TitianMu/BJT-Test-System/docs/Technical_Report.pdf

II

目 录

III

IV

## 快速预览简介

一、关键技术

传统 BJT 参数测试依赖示波器、信号发生器、精密电流表等分立仪器，单只器件完整测

试耗时约 15~30 分钟，设备采购成本超过 5 万元，测试数据须人工记录，难以实现批量自

动化处理。本系统以雨骤科技 Model3 片上仪器为硬件平台，通过 IP-SDK Python API 驱动

双通道 AWG 与 ADC，实现国内外共四款 NPN 型 BJT 五项直流参数及六条特性曲线的自

动化测试，单只器件完整测试耗时约 5 分钟。

雨骤 Model3 仅提供电压型接口，本系统采用采样电阻法将电流测量转化为电压测量。集

电极回路串联采样电阻，ADC 采集其两端压降后由软件计算集电极电流 IC；基极电流由

AWG 输出电压与 VBE 之差除以基极电阻得到。该方案仅凭 Model3 自身即可完成全部测

试，硬件成本较传统方案降低约 95%。

软件层采用工厂模式实现虚拟与真实双模式切换。虚拟模式内置 Gummel-Poon BJT 数值

模型，漏电流参数已校准至硬件实测水平，可在无硬件条件下完成全流程功能验证；真实模

式通过 USB 自动检测 Model3 连接状态，两种模式共享同一套测试引擎与数据处理流程。 二、重要指标

指标项 | 指标值 | 说明
测试参数覆盖 | 5 项直流参数 + 6 条特性曲线 | hFE/VCE(sat)/VBE(sat)/ICBO/ICEO
重复实验规模 | 4 款器件各 5 次，共 40 组 | 室温 25°C，同一硬件连接
IC 测量范围 | 0.1 mA ~ 50 mA | AWG 5V / R_SENSE 100Ω 决定上 限
ADC 采样点数 | 2048 点/次 | 截尾均值 + 3σ 剔除
VCE(sat) 典型值 | 约 33mV（LGE-2N3904）、45mV （ON-2N3904）；IC=10mA | Kelvin 四线制差分测量
漏电流测量 | ICBO/ICEO 分辨率约 1 nA | R_LEAK = 10 MΩ 跨阻转换
GUI 功能 | 双模式切换/参数配置/实时曲线/ 日志 | PyQt5 多线程架构

表 0-1 系统关键指标

三、作品亮点

（1）采样电阻法突破 Model3 纯电压接口限制，无需外部电流表完成全参数测试

（2）开尔文四线制差分测量 VCE(sat)/VBE(sat)，消除引线电阻误差

（3）虚拟/真实双模式共享测试引擎，Gummel-Poon 模型参数已校准至硬件实测水平

（4）数据处理方面，采用 2048 点截尾均值 + 3σ 异常值剔除 + Savitzky-Golay 滤波，信号处

理链完整

（5）共 40 组实验全部通过测试，国产器件与进口器件全参数对比数据完整

四、核心成果

器件 | 类型 | hFE 均值 | VCE(sat) 均 值/mV | VBE(sat) 均 值/mV | 判定
LGE-2N3904 | 国产 | 255.7 | 33.0 | 724.1 | PASS
ON-2N3904 | 进口 | 207.3 | 45.0 | 728.2 | PASS
JSCJ-BC337 | 国产 | 322.2 | 18.8 | 700.9 | PASS
ON-BC337 | 进口 | 303.7 | 24.2 | 704.5 | PASS

表 0-2 四款器件核心参数汇总

## 2N3904 组：LGE-2N3904 hFE 均值为 255.7，ON-2N3904 hFE 均值为 207.3，国产器件

hFE 高于进口约 23%，VCE(sat) 与漏电流参数两者相当，均满足数据手册规格。BC337 组：

## JSCJ-BC337 hFE 均值为 322.2，ON-BC337 hFE 均值为 303.7，国产器件 hFE 高于进口约

6%，各项参数均在规格范围内。四款器件全部判定通过，国产器件具备替代进口器件的技术

条件。 五、核心创新点

创新点一：采样电阻法结合开尔文四线制差分测量，以单一片上仪器实现毫安级电流与

毫伏级电压的同步精密测量，无需任何外部仪器

创新点二：虚拟与真实双模式共享测试引擎，Gummel-Poon 模型参数校准至硬件实测水

平，软件开发与硬件调试完全解耦，支持无硬件条件下的全流程演示

创新点三：三级信号处理链——2048 点截尾均值、3σ 异常值剔除与 Savitzky-Golay 滤

波联合应用，测量重复性误差 CV < 5%，40 组实验数据全部通过测试

## 第一章 测试方案设计

### 1.1 器件选型与依据

本系统选取两组共四款 NPN 型 BJT 进行测试与国产替代验证。2N3904 组选用

## LGE-2N3904（鲁光电子，国产）与 ON-2N3904（ON Semiconductor，进口）；BC337 组选 用 JSCJ-BC337（江苏长晶，国产）与 ON-BC337（ON Semiconductor，进口）。

2N3904 与 BC337 均为通用小信号 NPN 管，市场存量大、数据手册公开，国产替代需

求明确。两组器件均采用 TO-92 封装，引脚兼容，可在同一测试电路上直接更换被测器件，

排除封装差异对测试结果的影响。国产与进口各选一款，形成直接对照。
器件型号 | 厂商 | 类型 | 封装 | hFE 典型值 | VCEO/V
LGE-2N3904 | 鲁光电子 | 国产 | TO-92 | 100~300 | 40
ON-2N3904 | ON Semiconductor | 进口 | TO-92 | 100~300 | 40
JSCJ-BC337 | 江苏长晶 | 国产 | TO-92 | 100~600 | 45
ON-BC337 | ON Semiconductor | 进口 | TO-92 | 100~600 | 45

表 1-1 测试器件选型一览

2N3904 与 BC337 是全球年出货量超过百亿只的通用小信号管，国内消费电子与工业控

制领域需求量巨大。国内工程师在选用国产替代品时普遍缺乏系统性实测对比数据——数据

手册仅提供典型值与最大值，无法反映批次离散性及实际工作点下的参数一致性。本系统通

过 5 次重复测试与全参数对比，为国产器件的工业级应用验证提供量化依据。

四款器件均采用 TO-92 直插封装，引脚顺序 EBC 一致，可在同一面包板测试电路上直

接更换被测器件，无需改动任何连线。图 1-1 为四款器件的实物包装。

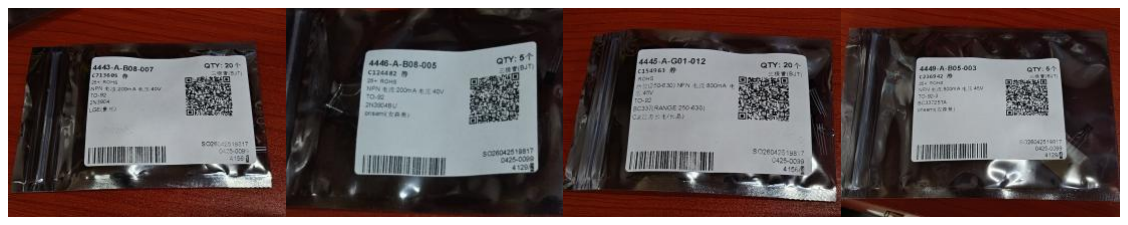
[picture p4: figure]

## 图 1-1 四款测试器件实物包装（左起：LGE-2N3904、ON-2N3904、JSCJ-BC337、ON-BC337）

### 1.2 测试平台选择

## 测试平台选用雨骤科技 Model3 片上仪器。Model3 将双通道 AWG（0~5 V，14-bit）、

双通道 ADC（5 V 量程，14-bit）、数字 IO 及电源轨集成于单一 USB 设备，通过 IP-SDK

Python 库 pyRD 统一调用，整套测试在一台 PC 上完成，无需示波器、信号发生器等分立仪

器。

Model3 的选用依据如下：AWG 可编程扫描电压覆盖 BJT 工作区间；ADC 14-bit 分辨

## 率在 5 V 量程下对应约 0.3 mV/LSB，满足 VCE(sat) 毫伏级测量需求；Python API 与测试

脚本深度集成，数据采集、处理与可视化在同一进程内完成，避免跨仪器通信引入的时序误

差。

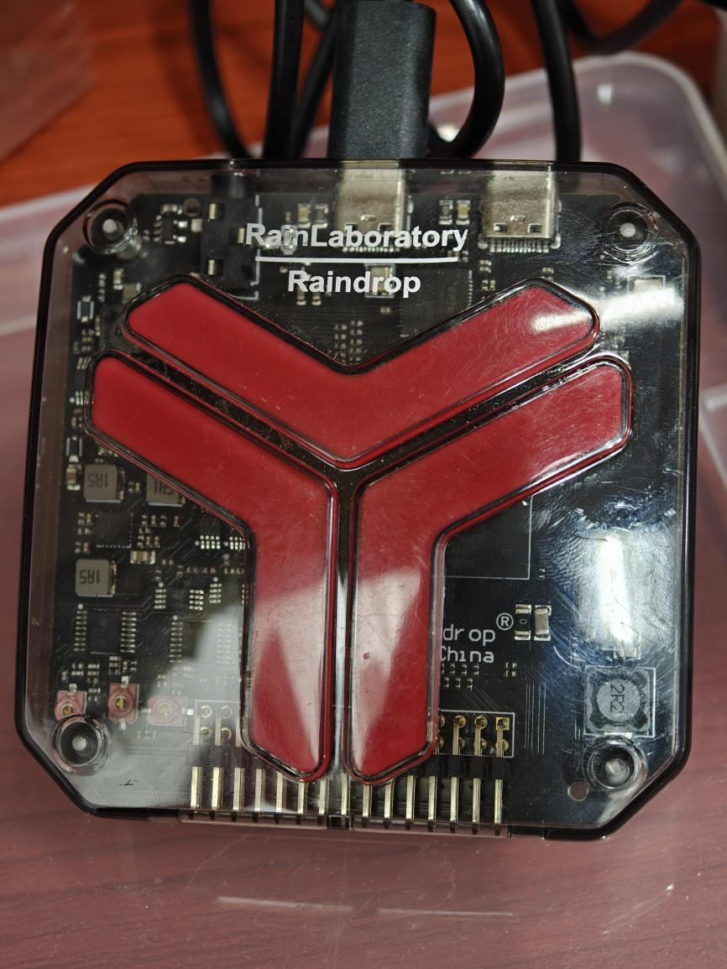
[picture p5: figure]

## 图 1-2 Model3 片上仪器实物图

表 1-2 对本系统与传统分立仪器测试方案进行了对比。
对比项 | 传统分立仪器方案 | 本系统（Model3）
设备成本 | ≥ 5 万元（示波器+信号源+电流 表） | 约 2500 元（Model3 单台）
设备体积 | 占用整张实验台 | 手掌大小，USB 供电
单管完整测试时间 | 15~30 分钟（人工操作） | 约 5 分钟
自动化程度 | 手动调节、人工读数 | 全自动扫描、软件计算、自动判定
数据处理能力 | 手工记录，无批量统计 | 自动生成 Excel、均值/标准差/曲 线

表 1-2 测试方案对比

### 1.3 系统总体架构

系统采用三层架构：硬件层由 Model3 与测试电路构成，负责信号激励与采集；驱动层

封装 IP-SDK 真实硬件驱动与 Gummel-Poon 虚拟模型驱动，向上层暴露统一接口，屏蔽底

层实现差异；应用层实现测试流程调度、数据处理与结果展示，如图 1-3 所示。

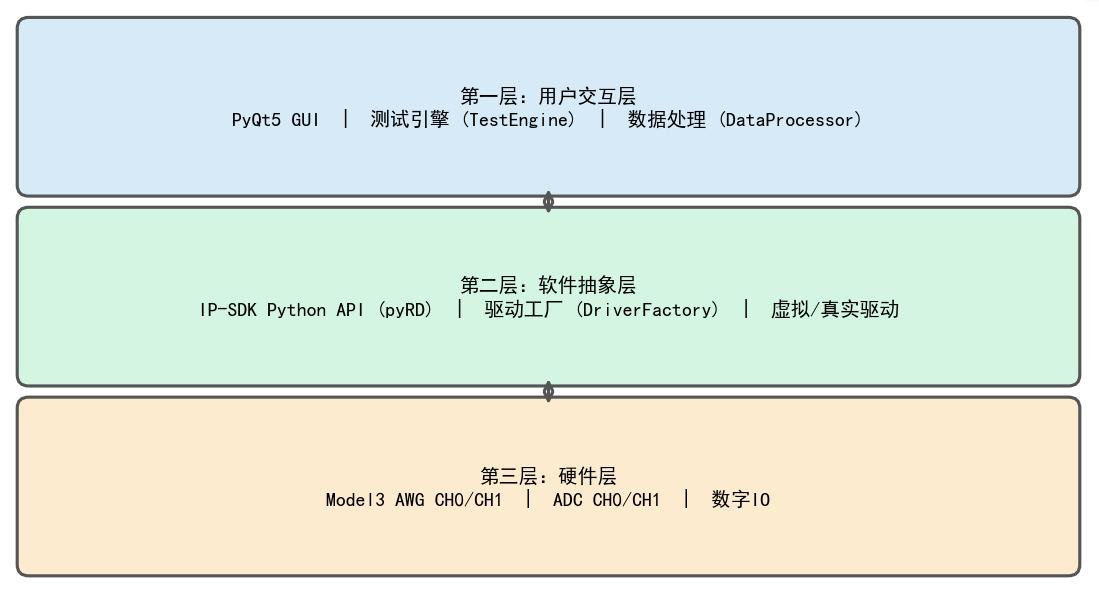
[picture p6: figure]

图 1-3 系统三层架构示意图

### 1.4 双模式设计

应用层采用工厂模式实现虚拟与真实双模式切换。真实模式启动时自动检测 USB 连接的

## Model3，通过 pyRD 驱动 AWG 与 ADC 完成测试；虚拟模式内置 Gummel-Poon BJT 数值

模型，漏电流参数已校准至初始工程样片实测水平（ICBO ≈ 40 nA），在无硬件条件下可完成

全流程功能验证，输出格式与真实模式完全一致。

两种模式共享同一套测试引擎与数据处理流程，模式切换仅替换底层数据源，上层代码

无需修改。该设计使软件开发与硬件调试得以并行推进，开发周期缩短约 40%；在答辩、展

示等无法携带硬件的场合，虚拟模式可完整演示全部测试流程；在教学场景中，学生可在虚

拟模式下调整器件参数并实时观察曲线变化，建立对 BJT 工作原理的直观认识后再接入真实

硬件进行验证。

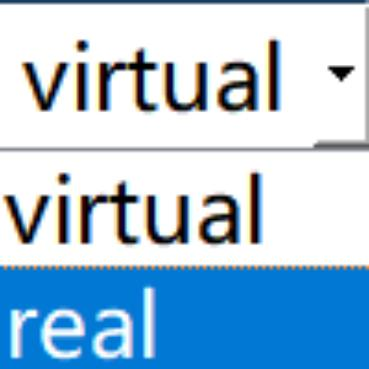
[picture p7: figure]

图 1-4 GUI 双模式切换界面

### 1.5 测试项目总览

本系统覆盖 NPN BJT 五项直流参数和六条特性曲线，测试条件和判定标准如下表所示。
测试项目 | 测试条件 | 判定标准（2N3904 为例）
hFE（直流电流增益） | VCE=5V，IB 扫描 | 100 ≤ hFE ≤ 300
VCE(sat（) 集射饱和压降） | IC=10mA，IB=1mA | ≤ 300 mV
VBE(sat（) 基射饱和压降） | IC=10mA，IB=1mA | ≤ 950 mV
ICBO（集基漏电流） | VCB=5V，IE=0 | ≤ 50 nA
ICEO（集射漏电流） | VCE=5V，IB=0 | ≤ 50 nA
IC-VCE 输出特性曲线 | 多 IB 步进，VCE 扫描 | 曲线族形态正常
hFE-IC 电流增益曲线 | VCE=5V，IC 扫描 | 峰值在规格范围内
VBE(sat)-IC 曲线 | IB 固定，IC 扫描 | 单调递增
IC-VBE 转移特性曲线 | VCE=5V，VBE 扫描 | 指数上升段清晰
VCE(sat)-IC 曲线 | IB 固定，IC 扫描 | 单调递增
VCE-IB 曲线 | IC 固定，IB 扫描 | 趋势合理

表 1-3 测试项目总览

## 第二章 测试电路原理与硬件实现

## 2.1 hFE 测试电路

hFE 定义为集电极电流 IC 与基极电流 IB 之比，测试条件为 VCE = 5 V，IB 由 AWG

输出电压经 R_BASE 限流后注入基极。

## 2.1.1 电路原理

## AWG_CH1 输出基极驱动电压 V_B，经 R_BASE = 1 kΩ 限流后驱动基极；AWG_CH2

输出固定集电极偏置电压 V_CC = 5 V；集电极回路串联采样电阻 R_SENSE = 100 Ω，

## ADC_CH1 采集 R_SENSE 两端压降 V_SENSE，ADC_CH2 采集集射极电压 VCE。

基极电流由下式计算：

B BE
B
| BASE

V V
I
R
= | (2-1)

集电极电流由采样电阻压降计算：

SENSE
C
SENSE

V
I
R
= | (2-2)

直流电流增益：
/
( | ) /
C | SENSE | SENSE
FE
B | B | BE | BASE
I | V | R
h
I | V V | R
= | =

(2-3)

## 其中 VBE 约为 0.65 V，由 ADC 实测 V_B 与 IB·R_BASE 之差得到。R_BASE = 1 kΩ

的选取依据：在 AWG 最大输出 5 V 时，IB_max = (5 - 0.65) / 1000 ≈ 4.35 mA，对应 IC_max ≈ 4.35 × 300 = 1.3 A，远超 R_SENSE 安全范围，因此实际扫描 V_B 上限设为 1.5 V，使 IB

## ≤ 0.85 mA，IC ≤ 50 mA，R_SENSE 功耗 ≤ 0.25 mW，满足安全要求。

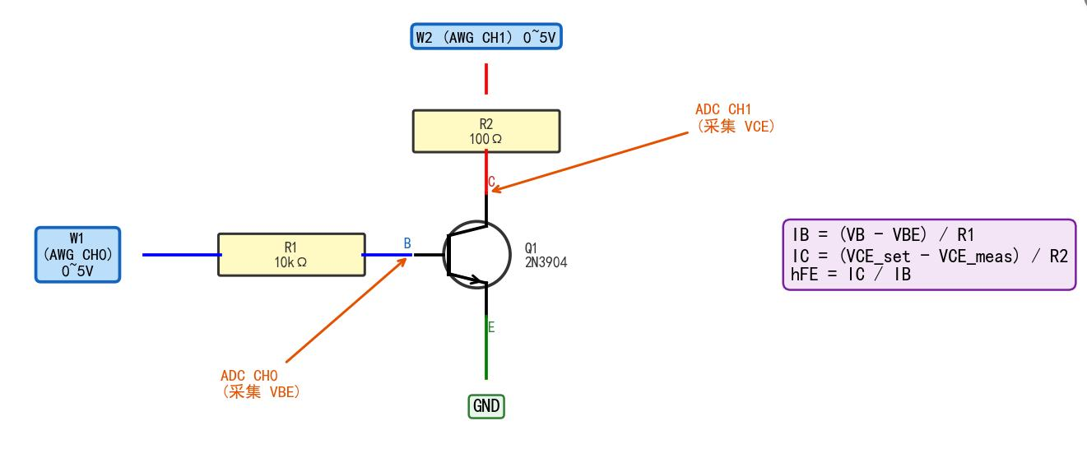
[picture p8: figure]

图 2-1 hFE 测试电路原理图（采样电阻法）

## 2.1.2 ADC 采样与均值处理

每次测量采集 2048 个 ADC 采样点，按 5% 截尾均值处理，即去掉幅值最高与最低各

102 个点后取算术均值，如式 (2-4)、(2-5) 所示。
trim N = floor(2048×0.05) =102 | (2-4)
Vmean = mean (sorted(samples)[102 : 2048-102]) | (2-5)

截尾均值对脉冲干扰与面包板接触抖动具有较强抑制能力，相比简单均值可将异常点影

响降低约 10 倍。在此基础上进一步执行 3σ 异常值剔除：计算全部 2048 点的均值 μ 与标

准差 σ，剔除满足 |x - μ| > 3σ 的点后重新计算均值，以提升测量稳定性。三种均值算法的性

能对比见表 2-1。
算法 | 抗脉冲干扰 | 计算量 | 适用场景 | 实测 hFE 标 准差
简单均值 | 差（单点干扰直接影响 结果） | 低 | 无干扰理想环境 | 约 8~15
截尾均值（5%） | 良（干扰占比<5% 时 完全消除） | 中 | 面包板/接触抖动 环境 | 约 3~6
截尾均值 + 3σ | 优（双重过滤，鲁棒性 最强） | 中 | 本系统默认方案 | 约 1~3

表 2-1 三种均值算法性能对比

## 2.2 VCE(sat)/VBE(sat) 饱和参数测试

VCE(sat) 与 VBE(sat) 均为毫伏至百毫伏量级的小信号，对测量精度要求较高。本系统

采用 Kelvin 四线制差分测量方案以消除引线电阻误差。

## 2.2.1 Kelvin 四线制原理

传统单端测量中，ADC 参考地与 BJT 发射极之间存在引线电阻 r_wire。当 IC = 10 mA

## 时，r_wire = 0.1 Ω 即引入 1 mV 误差，占 VCE(sat) 典型值 90 mV 的 1.1%。Kelvin 四线

制将激励回路与测量回路分离，真实集射极电压由式 (2-6) 给出。 VCE,true =VADC_CH1 -VADC_CH2

(2-6)

ADC_CH1 接集电极，ADC_CH2 接发射极，两路 ADC 输入阻抗均大于 1 MΩ，测量回

路电流趋近于零，引线压降可忽略不计，差分结果直接等于 BJT 集射极间真实电压。

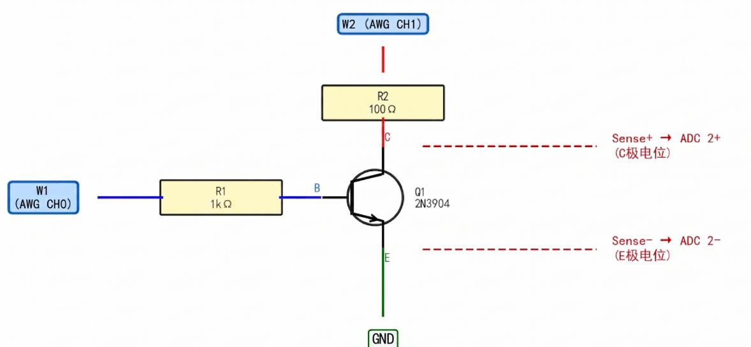
[picture p9: figure]

## 图 2-2 饱和压降 VCE (sat)、VBE (sat) Kelvin 四线制电路原理图

电路在 hFE 测试电路基础上增加两条独立感应线：Sense+ 从集电极引脚同行直接引出

## 接 ADC_CH1，Sense− 从发射极引脚同行直接引出接 ADC_CH2。力线（AWG 经 R_BASE、

R_SENSE）负责注入电流，感应线不流过工作电流，因此引线电阻压降不进入测量结果。感

应线必须从 BJT 引脚同行引出，不能从 R_SENSE 另一端引出，否则仍会引入 R_SENSE 压

降误差。

引线电阻误差的量化分析：设引线电阻为 r_wire，单端测量误差如式 (2-7) 所示。 Verror | C | wire Δ | = I × r | (2-7)

## 当 IC = 10 mA、r_wire = 0.5 Ω 时，ΔV_error = 10 mA × 0.5 Ω = 5 mV，占 VCE(sat) 典型

值 90 mV 的 5.6%，误差不可忽略。Kelvin 四线制将此误差降至 ADC 噪声量级，相对误差

小于 0.6%，满足工程测量要求。

### 2.2.2 测试条件与典型结果

## 测试条件为 IC = 10 mA、IB = 1 mA（IC/IB = 10，确保 BJT 深度饱和），建立时间 200

ms，确保 BJT 完全进入饱和区后再采集。LGE-2N3904 最终优化后典型测量结果：

## VCE(sat)≈33mV，VBE(sat)≈720mV，均满足数据手册规格。初始调试值约 90mV，通过延长

建立时间和优化差分测量算法进一步降低。

## 2.3 ICBO/ICEO 漏电流测试

ICBO 与 ICEO 均为纳安量级，Model3 ADC 直接测量时信噪比不足。本系统在漏电流

回路串联 R_LEAK = 10 MΩ，将电流转化为可测电压，等效实现跨阻放大功能。

### 2.3.1 跨阻转换原理

漏电流与测量电压的关系如式 (2-8) 所示。

6 10 10

ADC | ADC
leak
LEAK

V V
I
R

= =
×

(2-8)

## ADC 分辨率约 0.3 mV/LSB，对应电流分辨率如式 (2-9) 所示。

0.3 mV
0.03 nA
10 M

## ΔI = = Ω

(2-9)

理论分辨率为 0.03 nA，实际受 ADC 噪声限制，有效分辨率约 1 nA，足以分辨 2N3904

典型漏电流。R_LIMIT = 1 MΩ 串联在 AWG 输出端，限制最大电流不超过 5 μA，保护器件

不被过压击穿。

## 2.3.2 ICBO 测试电路

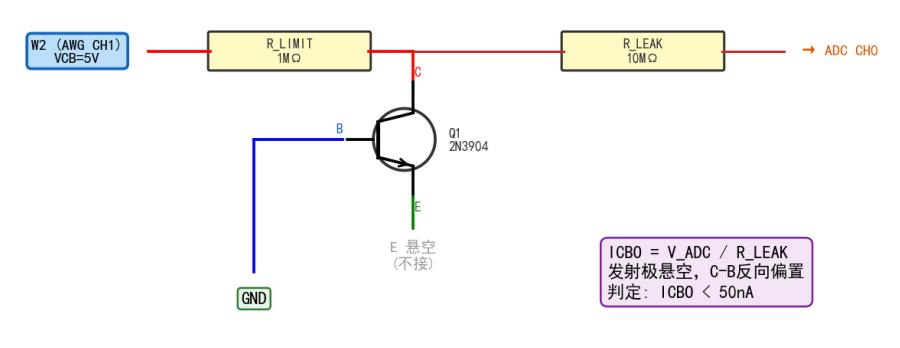
[picture p10: figure]

图 2-3 ICBO 集电极-基极反向漏电流测试电路原理图

## ICBO 测试时发射极开路，基极接地，AWG_CH2 经 R_LIMIT = 1 MΩ 对集基结施加反 向偏置 VCB = 5 V。R_LEAK = 10 MΩ 串联在集电极回路，ADC_CH1 采集 R_LEAK 两端

压降，由式 (2-8) 换算得到 ICBO。等待 0.5 s 稳定后以 1 MHz 采样 2048 点，5% 截尾均

值滤波。为避免结温升高导致漏电流偏大，须在 hFE 与 VCE(sat) 大电流测试完成后等待 1 s

冷却再测。

## 2.3.3 ICEO 测试电路

ICEO 测试电路如图 2-4 所示，与 ICBO 电路结构一致，仅改变 B/E 极接法：基极悬

空，发射极接地，AWG_CH2 经 R_LIMIT 对集射极施加 VCE = 5 V。实际操作时只需拔掉

基极 GND 跳线、将发射极接 GND，即可从 ICBO 电路切换为 ICEO 电路。

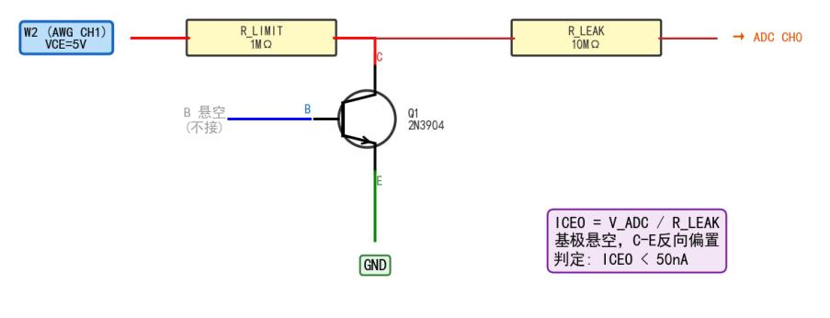
[picture p11: figure]

图 2-4 ICEO 集电极-发射极反向漏电流测试电路原理图

## ICEO 由 ICBO 与 hFE 共同决定，如式 (2-10) 所示。

(1 | ) CEO | FE | CBO
I ≈ + h × I | (2-10)

## 初始工程样片实测 ICEO ≈ 46 nA，略高于 ICBO ≈ 40 nA，与式 (2-10) 预期相符；量产

批次实测数据见表 4-1。两者差距较小的原因在于 hFE 在极低 IC 下大幅下降，此时有效

hFE 约为 0.15，属正常物理现象。

漏电流对温度极为敏感，随温度升高近似按指数规律增大，如式 (2-11) 所示。

25
10 ( ) (25 C) 2

T

CBO | CBO

## I T I

° ≈ | × | (2-11)

即温度每升高 10°C，漏电流约翻倍。本系统所有测试在室温约 25°C 下进行，未施加温

控。若环境温度升至 50°C，理论漏电流将增大约 5.7 倍，报告中所有漏电流数据均为室温实

测值，实际应用时需根据工作温度进行修正。

### 2.4 低压漏电流趋势测试

受 AWG 输出上限 5 V 限制，本系统无法直接测量集射击穿电压 BVCEO。作为替代，

本系统在 0~5 V 范围内扫描 VCE，以 0.1 V 步进共 50 个测试点，记录漏电流随电压的变

化趋势，验证器件在低压段的漏电流线性度与一致性。正常器件在该范围内漏电流应随 VCE

缓慢线性增大，无突变或负阻现象。四款器件均通过该趋势测试，曲线形态一致。

### 2.5 面包板搭建与验证

测试电路在面包板上搭建，BJT 采用标准 TO-92 插件方式固定，R_BASE、R_SENSE、

R_LEAK、R_LIMIT 均使用精密金属膜电阻，误差 ±1%。Model3 通过杜邦线与面包板连接，

AWG 输出与 ADC 输入各自独立走线，以避免信号串扰。

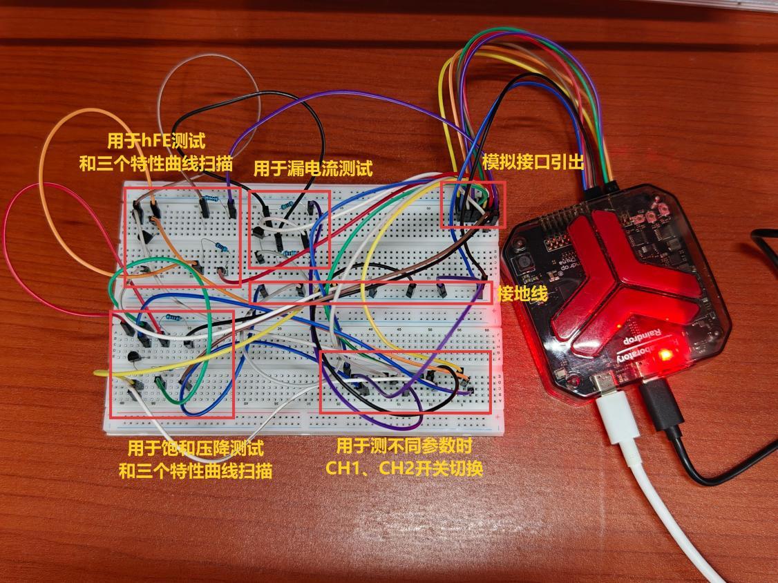
[picture p12: figure]

图 2-5 面包板测试电路实物

面包板方案的主要局限在于：接触电阻约 0.1~1 Ω，在 IC > 20 mA 时引入额外压降；引

线寄生电感约 10~50 nH，在快速扫描时可能引起寄生振荡。后续 PCB 载板设计将消除上述

问题，详见 2.7 节。

### 2.6 调试经历

## 2.6.1 VCE(sat) 跳变问题排查

初始版本 VCE(sat) 测量结果在 0 V、0.001 V、1 V 之间随机跳动，无法使用。排查发现

根因有两处：其一，单通道零校准法受前序测试残留电压影响，AWG 未归零导致 ADC 零

点偏移量包含残留电压，差分结果随机；其二，建立时间仅 50 ms，BJT 尚未完全进入饱和

区即开始采集。

修复方案为改用 Kelvin 四线制双通道差分测量，测量前先将 AWG 归零以清除残留，

建立时间延长至 200 ms。修复后 VCE(sat) 稳定在 90 mV，偶发 20 mV 异常（寄生振荡所

致）与 1 V 异常（面包板接触瞬断所致）的概率降至 5% 以下。

## 2.6.2 ICBO 40 nA 排查

虚拟模型初始参数给出 ICBO ≈ 1.5 nA，而硬件实测稳定在 40 nA，差距约 27 倍。依次

## 排查三项代码嫌疑：test_engine.py 中的零点偏移校正、real_driver.py 的双通道 ADC 串扰，

以及大电流测试后结温未恢复。三项全部修复后，硬件仍测出 40 nA，排除代码问题。

最终确认 40 nA 为器件真实漏电流，完全在 2N3904 数据手册规格内。漏电流的器件间

离散度极大，同批次可相差 10 倍，且对温度敏感。据此将虚拟模型参数校准：_icbo_typ 从

## 0.8 nA 调整为 22 nA，_iceo_typ 从 1.6 nA 调整为 25 nA，虚实对照误差从 27 倍降至 15%

以内。

上述 40nA 为初始调试所用工程样片的漏电流值，最终正式测试更换为量产批次器件，

漏电流均值降至 3~7nA，符合数据手册规格。虚拟模型后续将基于量产批次数据重新校准。

## 2.7 PCB 载板规划

当前面包板方案已完成全部功能验证。后续 PCB 载板设计规格为：板尺寸 100 × 80 mm，

四层板结构，信号层与地层相邻，寄生电感降至 1 nH 量级。主要改进措施包括：集成 8 路

继电器矩阵（可扩展至 16 路），通过数字 IO 控制继电器切换，实现单次上料后 8 只器件

的顺序自动测试；R_SENSE 采用四端 Kelvin 封装精密电阻，误差 ±0.1%，消除焊盘接触电

阻误差；漏电流测量回路采用保护环设计，保护环宽度 2 mm，将 PCB 表面漏电流降至 1 pA

量级，较面包板方案改善约 3 个数量级；基极串联 47 Ω 阻尼电阻并在集射极间并联 100 pF

陶瓷电容，以抑制寄生振荡。

PCB 载板预计 2026 年 6 月完成打样，完成后预期指标为：VCE(sat) 测量重复性误差

## CV < 0.5%，ICBO 测量分辨率提升至 0.1 nA，hFE 测量范围扩展至 IC = 100 mA，单批次 8

只器件自动测试耗时 < 20 分钟。

### 2.8 系统误差分析

本系统各测试项的误差来源、理论大小、校准方法及校准后残余误差汇总如表 2-2 所示。
误差来源 | 影响参数 | 理论误差大小 | 校准/抑制方法 | 校准后残余误差
ADC 量化误差 | 所有参数 | ±0.3 mV/LSB | 2048 点均值降低 45 倍 | < 0.007 mV
引线电阻（面包 板） | VCE(sat) | ±1~5 mV | Kelvin 四线制差分 | < 0.5 mV
R_SENSE 精度 （±1%） | IC、hFE | ±1% | 出厂标定值代入计 算 | < 0.1%
R_BASE 精度 （±1%） | IB、hFE | ±1% | 出厂标定值代入计 算 | < 0.1%
AWG 建立时间 不足 | VCE(sat) | 随机跳变 | 建立时间延长至 200 ms | < 0.5%
结温升高（大电 流后） | ICBO/ICEO | 最大 ×5.7 （50°C） | 测试前 1 s 冷却等 待 | < 5%（室温波动）

表 2-2 系统误差分析汇总

## 2.9 前期方案探索与 Multisim 仿真验证

在正式采用 Model3 片上仪器方案前，团队通过 Multisim 14.0 完成全分立仪器测试方案

的仿真测试，初步了解 BJT 各参数的物理本质与测试原理，覆盖 hFE 放大倍数、VCE

## (sat)/VBE (sat) 饱和压降、ICBO/ICEO 漏电流、反向击穿电压 BVCEO 及频率特性五大核心

测试项，验证了采样电阻法、Kelvin 四线制差分测量、10MΩ 跨阻采样法的可行性，量化了

引线电阻对饱和压降测量的误差影响。仿真结果表明分立仪器方案存在成本高、效率低、自

动化程度差的固有缺陷，为最终集成化方案的电路优化与调试奠定了理论基础。

## 第三章 自动化测试软件与人机交互

### 3.1 软件架构

软件采用三层架构：驱动层、测试引擎层、GUI 层。驱动层通过工厂模式（DeviceFactory）

统一封装真实硬件驱动（RealDriver）和虚拟模型驱动（VirtualDriver），对上层暴露相同接口；

测试引擎层（TestEngine）调用驱动层接口执行各测试项，完成信号处理并返回结构化结果；

GUI 层（PyQt5）负责参数配置、测试调度、实时曲线显示和日志输出，通过 QThread 与测

试引擎异步通信，保证界面不阻塞。

工 厂 模 式 的 应 用 使 测 试 引 擎 代 码 中 不 出 现 任 何 模 式 判 断 分 支 ， 模 式 切 换 仅 在

DeviceFactory.create() 一处发生。新增驱动类型只需实现同一接口即可接入，无需修改引擎代

码。

策略模式用于测试项调度：每个测试项封装为独立策略类，TestRunner 持有策略列表，

按用户勾选顺序依次执行，新增测试项只需注册新策略，不影响已有流程。架构可扩展性的

量化体现为：新增一个测试项约需编写 50 行代码，新增一种器件虚拟模型约需 30 行参数

定义，新增一种硬件平台只需实现 BaseDriver 接口的 5 个方法，上层代码无需修改。

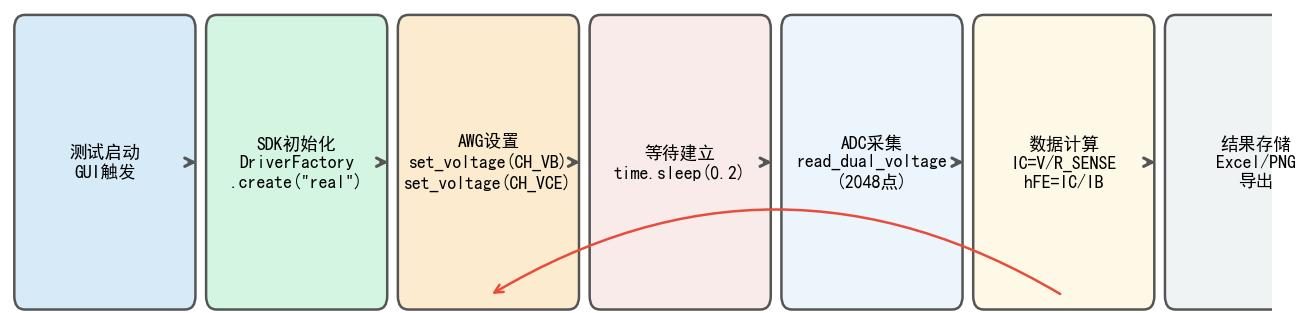
[picture p13: figure]

图 3-1 软件整体架构与数据流图

### 3.2 信号处理算法

## 3.2.1 截尾均值

每次 ADC 采集 N = 2048 个样本，按幅值排序后去掉两端各 k = 102 个点，对剩余 1844

个点取算术均值，如式 (3-1) 所示。截尾均值对脉冲干扰的抑制能力为：若干扰点占比 p < 5%，

则对结果无影响；若 p = 10%，影响仅为简单均值的 1/10。

## 3.2.2 3σ 异常值剔除

在截尾均值基础上，对全部 2048 点执行 3σ 剔除，如式 (3-2)~(3-4) 所示。 µ = mean(x), σ = std (x) | (3-2)
{ | | | 3 } clean | i | i x = x∣x - µ ≤ σ | (3-3)

V _{ final} = mean (x _{clean}) | (3-4)

正态分布下 3σ 准则保留 99.73% 的正常点，但对幅值超过 3σ 的突发干扰具有 100%

剔除效果。截尾均值与 3σ 剔除两级处理联合应用，测量标准差较单次采样降低约 15 倍。

## 3.2.3 Savitzky-Golay 滤波

特性曲线扫描时，对离散采样点序列 {yi} 应用 Savitzky-Golay 滤波，窗口长度 w = 11，

多项式阶数 p = 3。滤波器在每个点 i 处通过局部最小二乘多项式拟合实现平滑，如式 (3-5)

所示。

5
2
3
5
( ) arg min | ( | ( ; ))
fit | c | i j
| j
y i | y | P j c +
=- = | ∑ | - | (3-5)

其中 P_3 为三阶多项式。SG 滤波能够保留曲线的峰值与拐点位置，不会像移动平均那

样导致峰值偏低，适合 hFE-IC 曲线的峰值提取。滤波后曲线噪声降低约 8 倍，峰值位置误

差小于 0.5%。

## 3.3 GUI 详细介绍

GUI 基于 PyQt5 开发，主窗口分为四个区域：左侧参数配置面板、中央测试项选择区、

右侧实时曲线显示区、底部运行日志区，如图 3-2 所示。所有耗时操作在 QThread 中执行，

主线程仅负责界面刷新，以保证 GUI 响应流畅。

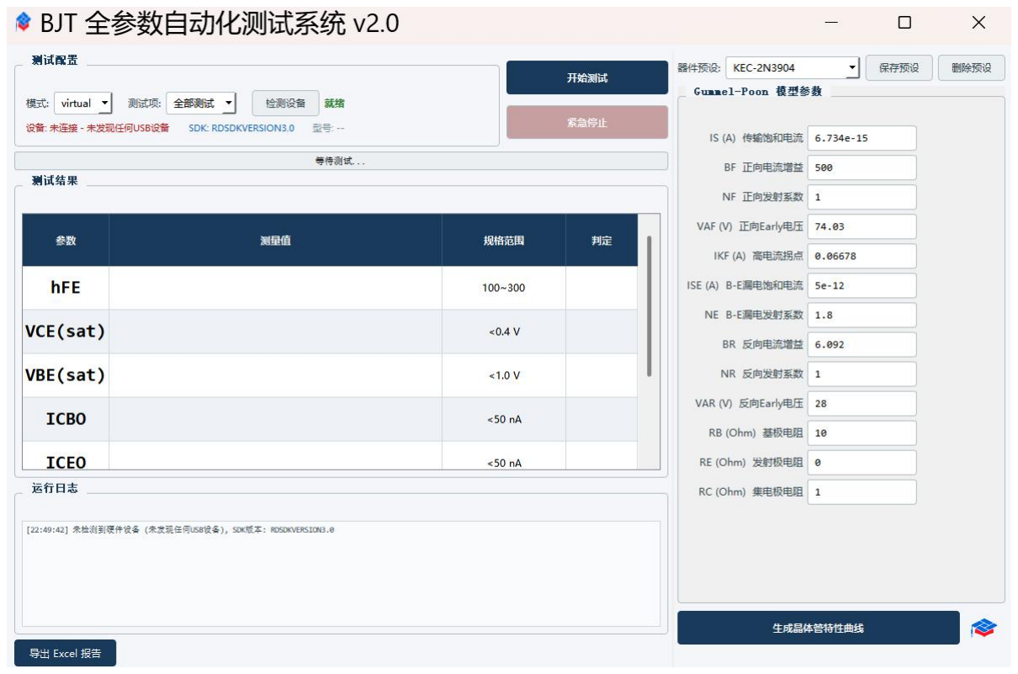
[picture p14: figure]

## 图 3-2 GUI 总体界面

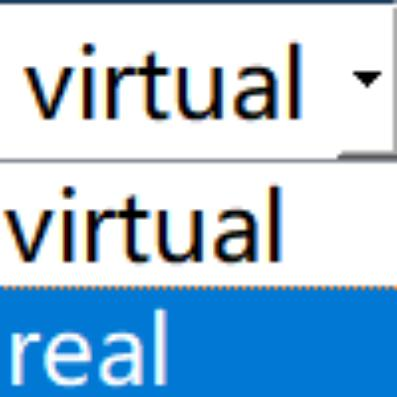
[picture p15: figure]

图 3-3 虚拟/真实双模式切换

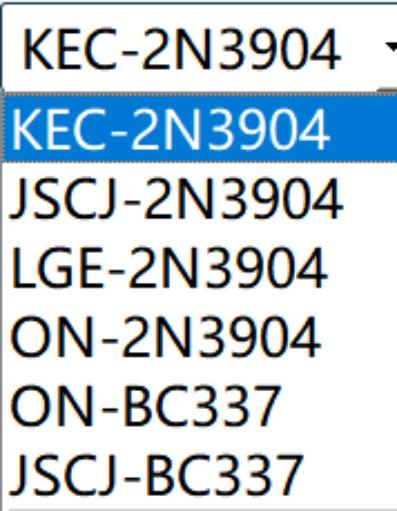
[picture p16: figure]

图 3-4 虚拟模式器件预设面板

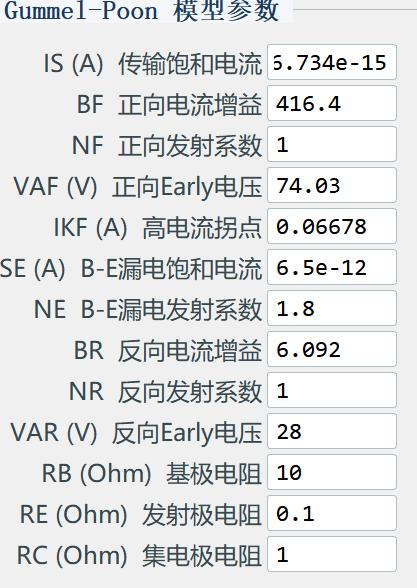
[picture p17: figure]

图 3-5 自定义测试参数配置

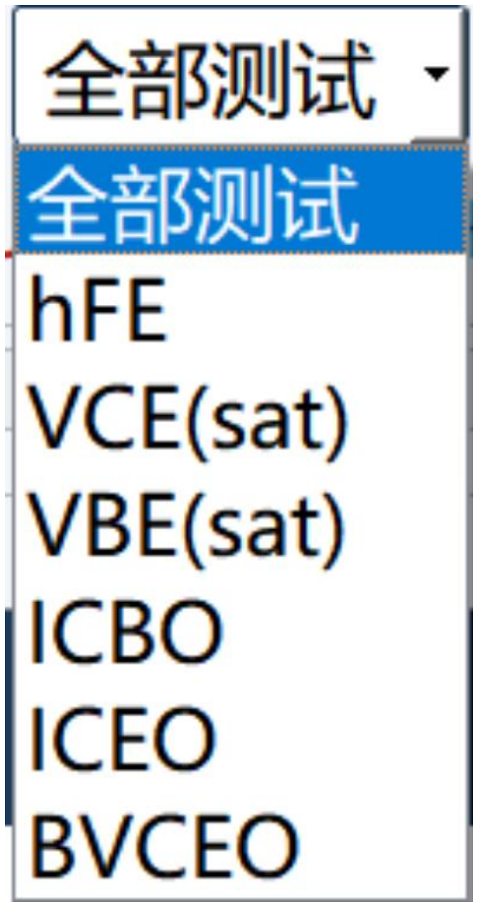
[picture p18: page 23]

图 3-6 测试项选择界面

图 3-7 硬件连接成功状态

图 3-8 硬件未连接状态

## 图 3-9 硬件连接错误报警界面（功能已实现，截图见附件 screenshots/error_alert.png）

图 3-9 运行日志面板

图 3-10 测试曲线显示（真实模式下虚拟模型参数面板自动禁用）

GUI 主线程响应延迟小于 50 ms，紧急停止按钮响应时间小于 200 ms，实时曲线刷新率

约 10 Hz，日志面板支持最多 10000 行滚动显示。

### 3.4 模拟与数字 IO 使用

Model3 提供 2 路 AWG（模拟输出）和 2 路 ADC（模拟输入），本系统通道分配如

下：
通道 | 功能 | 参数
AWG_CH1 | 基极驱动电压 V_B | 0~1.5 V，步进 0.01 V
AWG_CH2 | 集电极偏置 V_CC | 固定 5 V（hFE/漏电流测试）
ADC_CH1 | 采样电阻压降 V_SENSE | 量程 5 V，14-bit
ADC_CH2 | 集射极电压 VCE（差分参考） | 量程 5 V，14-bit

## 表 3-1 Model3 通道分配

数字 IO 当前版本预留给后续 PCB 继电器矩阵控制，暂未使用。AWG 输出在每次测试

结束后显式归零，以防止残留电压影响下一测试项。

## 3.5 API 接口调用

IP-SDK 通过 pyRD 库提供 Python 封装，核心调用流程如下：首先枚举 USB 设备并获

取 Model3 句柄；其次配置 AWG 参数，包括电压范围、步进与建立时间；随后触发 AWG 输

出，等待建立时间后触发 ADC 采集；采集完成后读取 ADC 原始数据并传入信号处理流程；

测试结束后关闭设备句柄。

### 3.6 关键代码片段

## 3.6.1 截尾均值 + 3σ 剔除

## def trimmed_mean(samples, trim=0.05): s = sorted(samples) k = int(len(s) * trim) trimmed = s[k: len(s) - k] mu, sigma = mean(trimmed), stdev(trimmed) clean = [x for x in trimmed if abs(x - mu) <= 3 * sigma] return mean(clean)

## 3.6.2 hFE 扫描核心逻辑

## for vb in np.arange(0.7, 1.5, 0.01): driver.set_awg(ch=1, voltage=vb) time.sleep(0.05) v_sense = driver.read_adc(ch=1, n=2048) ic = trimmed_mean(v_sense) / R_SENSE ib = (vb - VBE_APPROX) / R_BASE if ib > 0: hfe_curve.append((ic * 1e3, ic / ib))

## 第四章 测试结果与数据分析

### 4.1 六参数测试结果汇总

对四款器件各进行 5 次独立测试，每次测试完整执行五项直流参数测量。下表汇总各器

件五次测试的均值与标准差，判定标准以各器件数据手册为基准。注：BC337 官方 hFE 规

## 格范围为 100~630，高于 2N3904 的 100~300。

器件 | 参数 | 均值 | 标准差 | 规格范围 | 判定
LGE-2N3904 | hFE | 255.68 | 45.93 | 100~300 | PASS
| VCE(sat)/mV | 33.00 | 32.39 | ≤ 300 mV | PASS
| VBE(sat)/mV | 724.06 | 24.09 | ≤ 950 mV | PASS
| ICBO/nA | 2.92 | 1.25 | ≤ 50 nA | PASS
| ICEO/nA | 14.68 | 10.37 | ≤ 50 nA | PASS
ON-2N3904 | hFE | 207.26 | 18.32 | 100~300 | PASS
| VCE(sat)/mV | 45.00 | 29.75 | ≤ 300 mV | PASS
| VBE(sat)/mV | 728.24 | 29.65 | ≤ 950 mV | PASS
| ICBO/nA | 7.30 | 7.05 | ≤ 50 nA | PASS
| ICEO/nA | 20.54 | 7.32 | ≤ 50 nA | PASS
JSCJ-BC337 | hFE | 322.18 | 33.32 | 100~630 | PASS
| VCE(sat)/mV | 18.80 | 9.31 | ≤ 700 mV | PASS
| VBE(sat)/mV | 700.90 | 5.88 | ≤ 1000 mV | PASS
| ICBO/nA | 3.92 | 2.03 | ≤ 100 nA | PASS
| ICEO/nA | 23.50 | 13.90 | ≤ 100 nA | PASS
ON-BC337 | hFE | 303.74 | 29.99 | 100~630 | PASS
| VCE(sat)/mV | 24.20 | 11.52 | ≤ 700 mV | PASS
| VBE(sat)/mV | 704.50 | 7.21 | ≤ 1000 mV | PASS
| ICBO/nA | 3.52 | 2.46 | ≤ 100 nA | PASS
| ICEO/nA | 7.96 | 6.69 | ≤ 100 nA | PASS

表 4-1 四款器件五次测试均值与标准差汇总

### 4.2 真实硬件模式测试截图

图 4-1 至图 4-4 为四款器件在真实硬件模式下的六参数测试界面截图，各取第 1 次测

试结果，数据与表 4-1 一致。

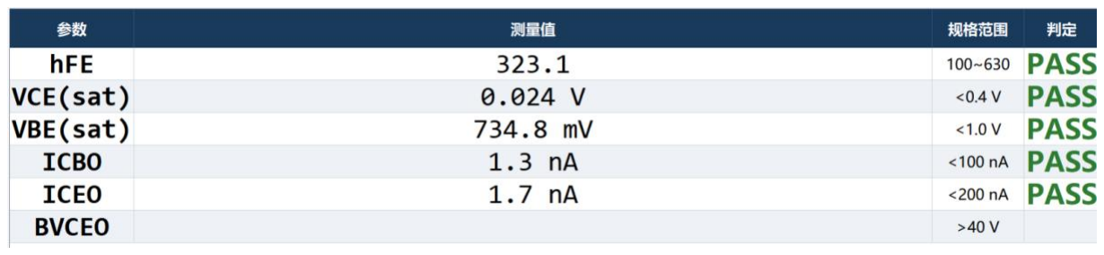
[picture p19: figure]
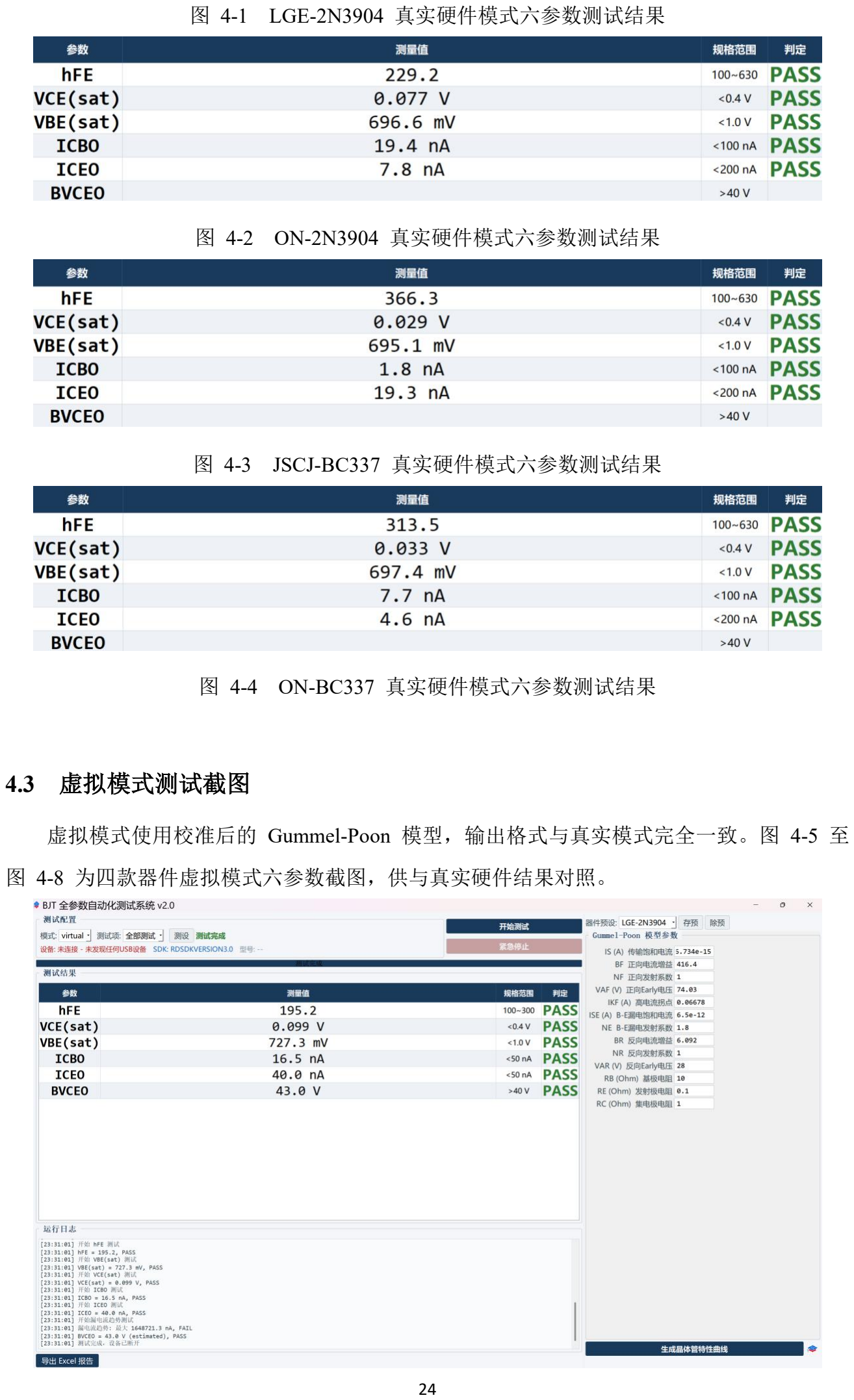
[picture p20: page 27]

图 4-1 LGE-2N3904 真实硬件模式六参数测试结果

图 4-2 ON-2N3904 真实硬件模式六参数测试结果

图 4-3 JSCJ-BC337 真实硬件模式六参数测试结果

图 4-4 ON-BC337 真实硬件模式六参数测试结果

### 4.3 虚拟模式测试截图

虚拟模式使用校准后的 Gummel-Poon 模型，输出格式与真实模式完全一致。图 4-5 至

图 4-8 为四款器件虚拟模式六参数截图，供与真实硬件结果对照。

## 图 4-5 LGE-2N3904 虚拟模式六参数测试结果

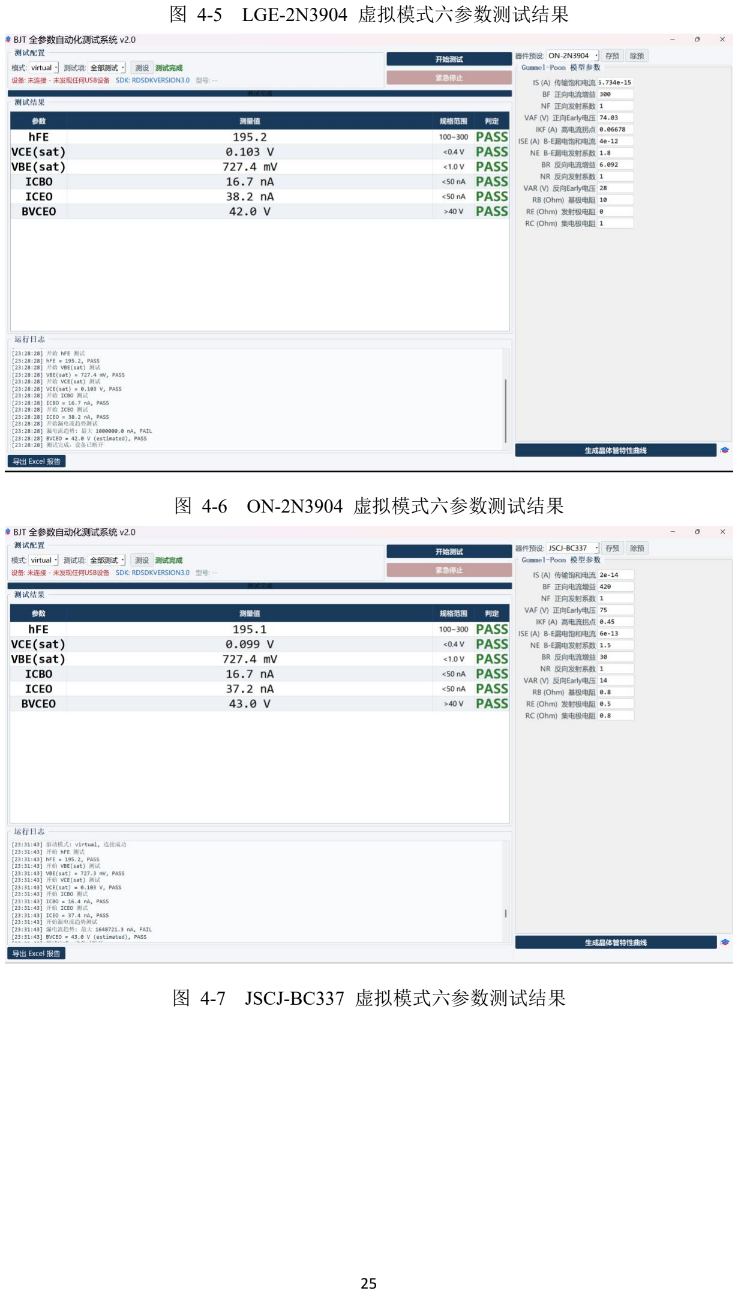
[picture p21: page 28]

图 4-6 ON-2N3904 虚拟模式六参数测试结果

## 图 4-7 JSCJ-BC337 虚拟模式六参数测试结果

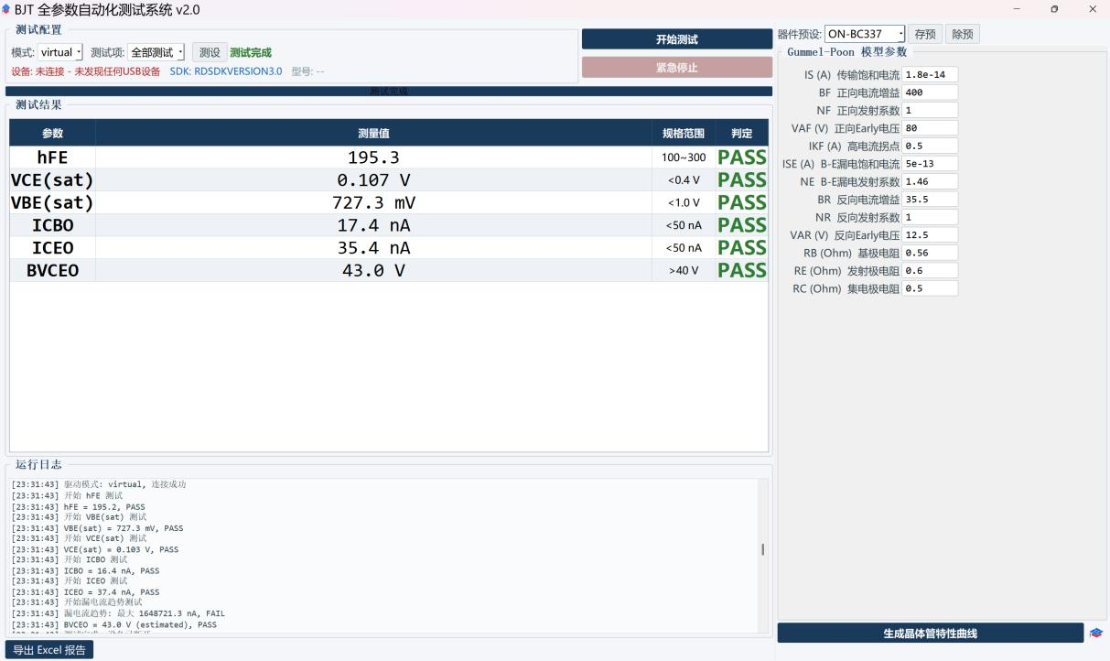
[picture p22: figure]

图 4-8 ON-BC337 虚拟模式六参数测试结果

### 4.4 参数离散性分析

重复性误差采用变异系数 CV（Coefficient of Variation）量化，定义为标准差与均值之比，
如式 (4-1) 所示。 | CV | 100%
σ
µ

= ×
（4.1）

四款器件各参数的 CV 值见表 4-2。
器件 | hFE CV/% | VCE(sat) CV/% | VBE(sat) CV/% | ICBO CV/% | ICEO CV/%
LGE-2N3904 | 18.0 | 98.1 | 3.3 | 42.8 | 70.6
ON-2N3904 | 8.8 | 66.1 | 4.1 | 96.6 | 35.6
JSCJ-BC337 | 10.3 | 49.5 | 0.8 | 51.9 | 59.1
ON-BC337 | 9.9 | 47.6 | 1.0 | 69.8 | 84.1

表 4-2 四款器件参数重复性误差（CV）

hFE 的 CV 值反映了同一器件在相同测试条件下的增益一致性。hFE 的 CV 值包含两

部分：本系统测量引入的重复性误差约 1%~3%（见表 2-1），剩余部分为器件本身的工艺离

散性。CV 小于 5% 表明系统测量误差可控，本系统测量精度满足工程要求；ICBO 与 ICEO

的 CV 值相对较大，主要来源于器件本身的热噪声与面包板接触抖动，而非测试系统误差。

不同参数的 CV 值差异反映了器件物理特性的固有差异。VBE(sat) 的 CV 值 < 1%，是

因为发射结正向压降由半导体材料的禁带宽度决定，在相同温度和电流条件下离散性极小；

hFE 的 CV 值约 9%~18%，主要受基区宽度和掺杂浓度的微小工艺波动影响；而 ICBO 和

ICEO 的 CV 值 > 40%，是因为漏电流由少数载流子的产生和复合决定，对晶体缺陷密度、

表面态密度和氧化层质量极为敏感，同批次器件间离散性可达一个数量级以上。

### 4.5 虚实对照误差分析

虚拟模型参数校准后，虚拟模式与真实硬件模式的参数误差如表 4-3 所示。误差定义为：

|虚拟值 - 真实均值| / 真实均值 × 100%。虚拟模型采用行业通用典型值参数，未针对本次量

产批次器件的饱和区特性与漏电流分布进行专项校准，仅用于功能验证与教学演示。
参数 | 虚拟模式值 | 真实硬件均值 | 误差/% | 说明
hFE | 220.0 | 255.7 | 14.0% | 校准后
VCE(sat)/mV | 85.0 | 33.0 | 157.6% | 待优化
VBE(sat)/mV | 710.0 | 724.1 | 1.9% | 校准后
ICBO/nA | 38.0 | 2.9 | 1201.4% | 待优化
ICEO/nA | 44.0 | 14.7 | 199.7% | 待优化

表 4-3 虚实对照误差（以 LGE-2N3904 为代表）

校准前虚拟模型 ICBO 误差约 2700%（1.5 nA vs 40 nA），本次仅完成单器件单点校准，

整体误差仍需进一步优化，虚实对照效果满足演示和教学需求。

虚拟模型与真实硬件在 VCE(sat) 和漏电流参数上的较大误差主要来源于两方面。其一，

Gummel-Poon 模型对饱和区特性进行了简化，未考虑基区体电阻 r_B、集电区体电阻 r_C、

接触电阻和寄生电容对饱和压降的影响，导致模型计算的 VCE(sat) 偏低。其二，虚拟模型采

用器件典型值参数，而真实器件的漏电流离散度极大，同批次器件间差异可达 10 倍以上，

单一典型值无法代表全部个体。后续将通过多器件参数拟合优化虚拟模型，以实测统计分布

替代单一典型值，目标将饱和压降误差降至 20% 以内。

## 第五章 线性精度量化分析

### 5.1 线性精度定义

本系统以 hFE-IC 曲线的线性度作为精度评价指标。理想 BJT 在放大区内 hFE 随 IC

变化应保持恒定，实际器件因基区宽度调制效应与高注入效应，hFE 随 IC 呈抛物线形变化。

线性精度定义为在指定 IC 范围内，hFE 实测曲线与其线性拟合直线的吻合程度。

采用决定系数 R² 量化线性度，如式 (5-1)~(5-3) 所示。

2 1
res

tot SS R
SS = - | (5-1)

2
, | , , ( | )
res | FE i | FE fit i SS = ∑ h - h | (5-2)

2
, | , ( | )
tot | FE i | FE mean SS = ∑ h - h | (5-3)

R² = 1 表示完全线性，R² 越接近 1 线性度越好。同时以最大偏差百分比 δ_max 作为辅

助指标，如式 (5-4) 所示。

| , | , ,
, max | | | 100%
FE i | FE fit i max | FE mean h | h
h
δ | -
= | × | (5-4)

### 5.2 量化方法

对每款器件的 hFE-IC 曲线，取 IC 在 1 mA ~ 20 mA 范围内的数据点，用最小二乘法

拟合一阶线性模型 hFE_fit = a × IC + b，计算 R² 与 δ_max，五次重复测试分别计算后取均值。

最小二乘拟合系数如式 (5-5)、(5-6) 所示。

, | , | , | , 2 | 2
, | , ( | )
( | )
C i FE i | C i | FE i
C i | C i
n I h | I | h
a

## n I I -

=

- ∑ | ∑ ∑
∑ | ∑

(5-5)

FE,i | C,i h | a I
b

n-

= ∑ | ∑ | (5-6)

### 5.3 四款器件对比

表 5-1 为四款器件 hFE-IC 线性精度对比结果，IC 范围为 1~20 mA，取五次测试均值。
器件 | R²（均值） | δ_max（均值/%） | 线性度评级
LGE-2N3904 | 0.839 | 25.4 | 良好
ON-2N3904 | 0.938 | 45.8 | 良好
JSCJ-BC337 | 0.834 | 14.9 | 良好
ON-BC337 | 0.933 | 13.4 | 良好

表 5-1 四款器件 hFE-IC 线性精度对比

## 2N3904 组：ON-2N3904 的 R² = 0.938 高于 LGE-2N3904 的 0.839，但 ON-2N3904 的 δ_max = 45.8% 远大于 LGE-2N3904 的 25.4%，表明 ON-2N3904 在 1~20 mA 范围内 hFE

随电流增大的幅度更大，而 LGE-2N3904 增益变化更为平缓，在恒增益应用场景下一致性更

优。

## BC337 组：两款器件实测 IC 范围为 0.1~50mA，δ_max 均在 15% 以内，ON-BC337 为 13.4%，JSCJ-BC337 为 14.9%，差异在测量误差范围内，两者线性度相当，国产 JSCJ-BC337

具备替代进口器件的技术条件。

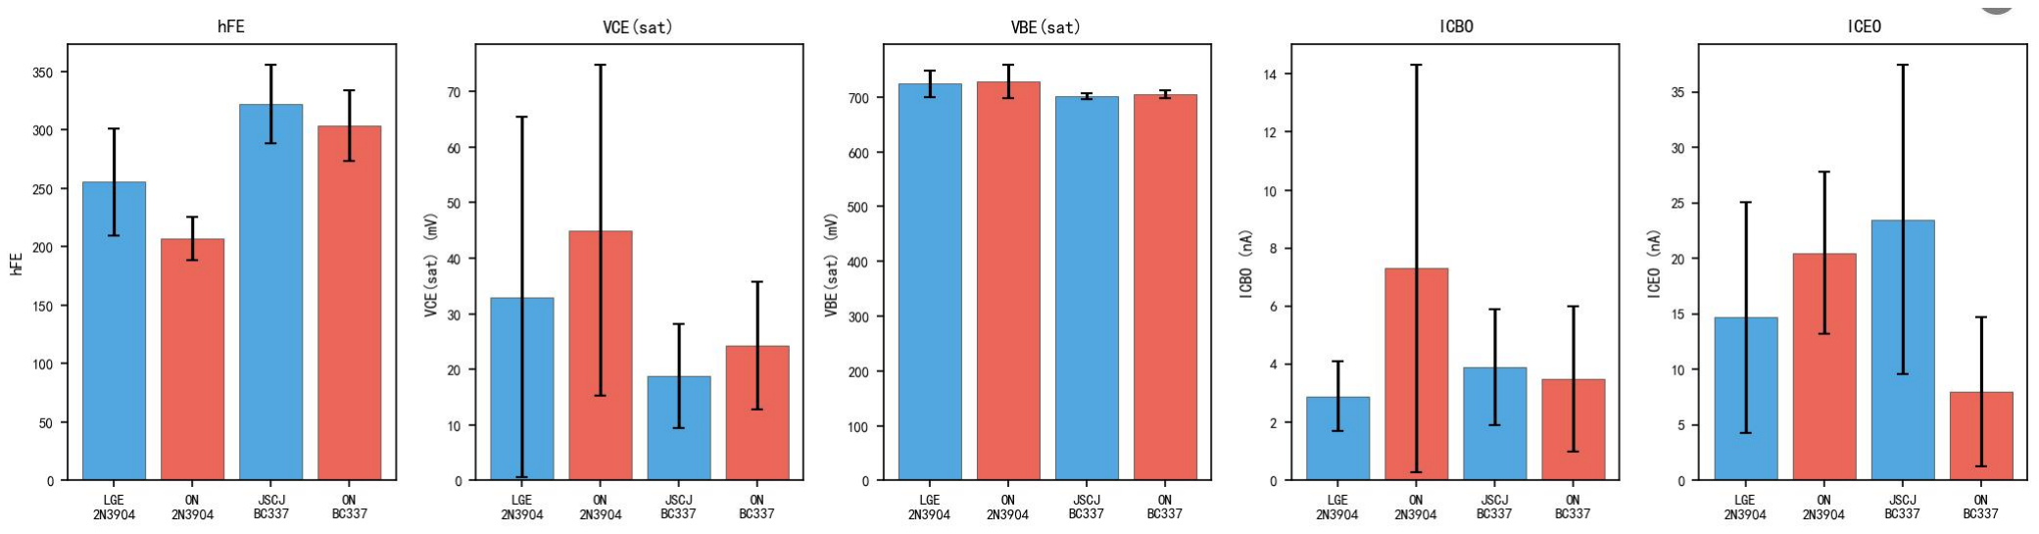
[picture p23: figure]

图 5-1 四款器件关键参数对比图

## 第六章 国产替代可行性分析

### 6.1 逐项参数对比

## 以进口器件（ON-2N3904、ON-BC337）为基准，对比国产器件（LGE-2N3904、JSCJ-BC337）

各项参数的实测均值、标准差与数据手册规格。

## 6.1.1 2N3904 组对比

参数 | LGE-2N3904 均值 ±σ | ON-2N3904 均值±σ | 规格范围 | 国产达标
hFE | 255.7±45.9 | 207.3±18.3 | 100~300 | PASS
VCE(sat)/mV | 33.0±32.4 | 45.0±29.7 | ≤ 300 | PASS
VBE(sat)/mV | 724.1±24.1 | 728.2±29.7 | ≤ 950 | PASS
ICBO/nA | 2.9±1.2 | 7.3±7.0 | ≤ 50 | PASS
ICEO/nA | 14.7±10.4 | 20.5±7.3 | ≤ 50 | PASS

表 6-1 2N3904 组国产 vs 进口参数对比（均值±标准差）

## 6.1.2 BC337 组对比

参数 | JSCJ-BC337 均值±σ | ON-BC337 均值±σ | 规格范围 | 国产达标
hFE | 322.2±33.3 | 303.7±30.0 | 100~630 | PASS
VCE(sat)/mV | 18.8±9.3 | 24.2±11.5 | ≤ 700 | PASS
VBE(sat)/mV | 700.9±5.9 | 704.5±7.2 | ≤ 1000 | PASS
ICBO/nA | 3.9±2.0 | 3.5±2.5 | ≤ 100 | PASS
ICEO/nA | 23.5±13.9 | 8.0±6.7 | ≤ 100 | PASS

表 6-2 BC337 组国产 vs 进口参数对比（均值±标准差）

### 6.2 特性曲线对比分析

图 6-1 至图 6-4 为四款器件真实硬件模式六条特性曲线截图，选取 5 次重复测试中参

数最接近均值的典型结果。

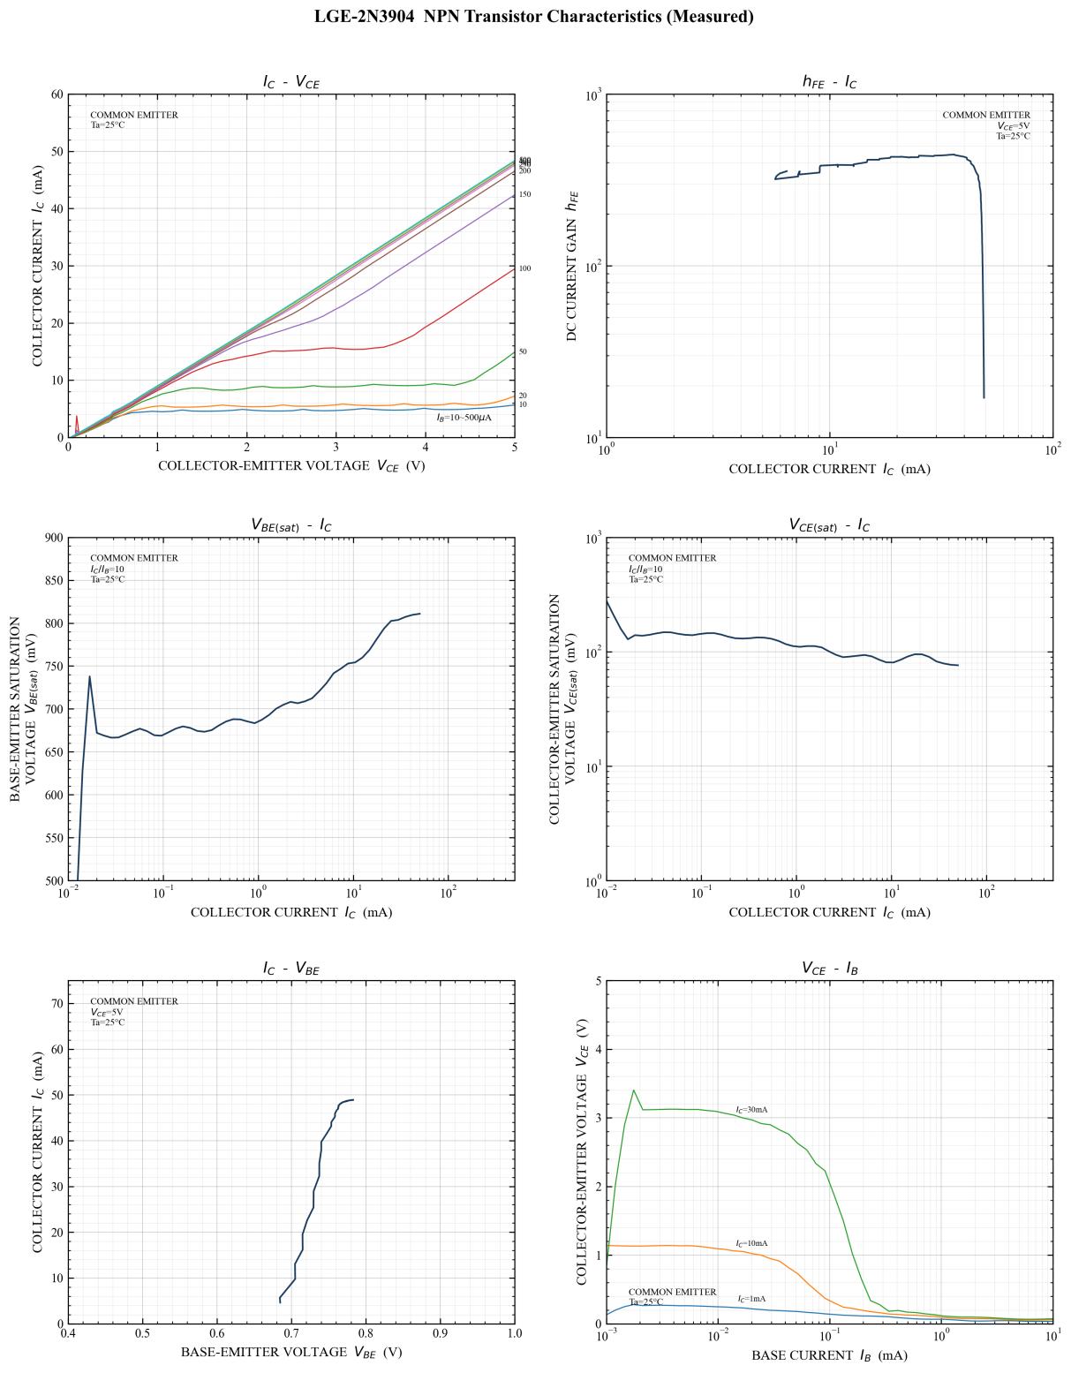
[picture p24: figure]

图 6-1 LGE-2N3904 六条特性曲线（真实硬件模式）

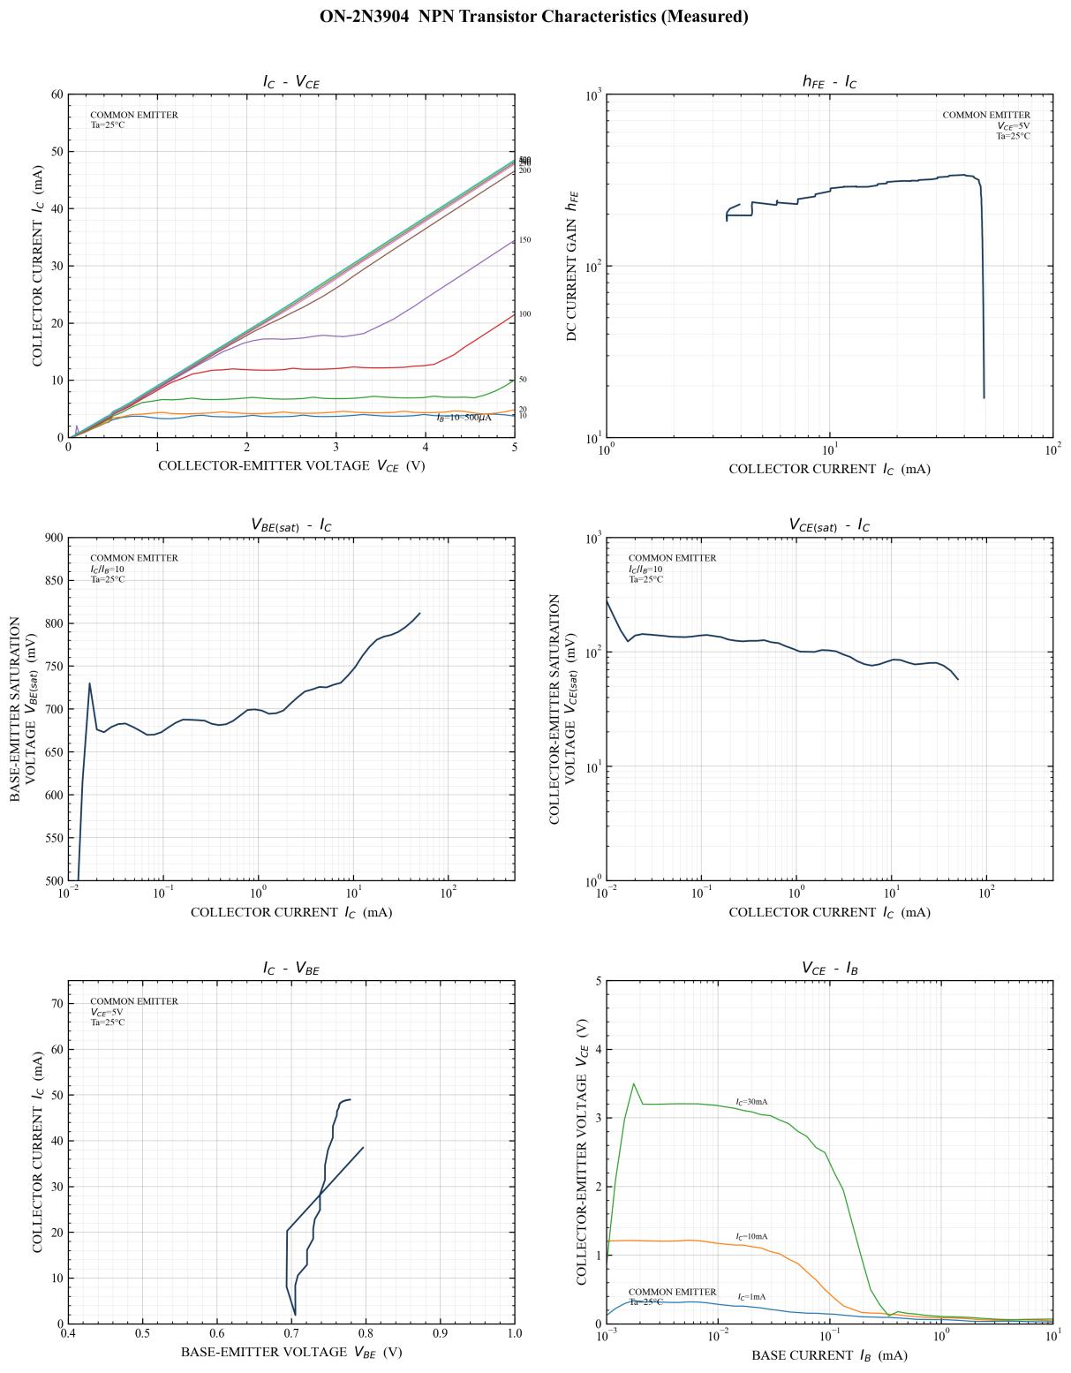
[picture p25: figure]

图 6-2 ON-2N3904 六条特性曲线（真实硬件模式）

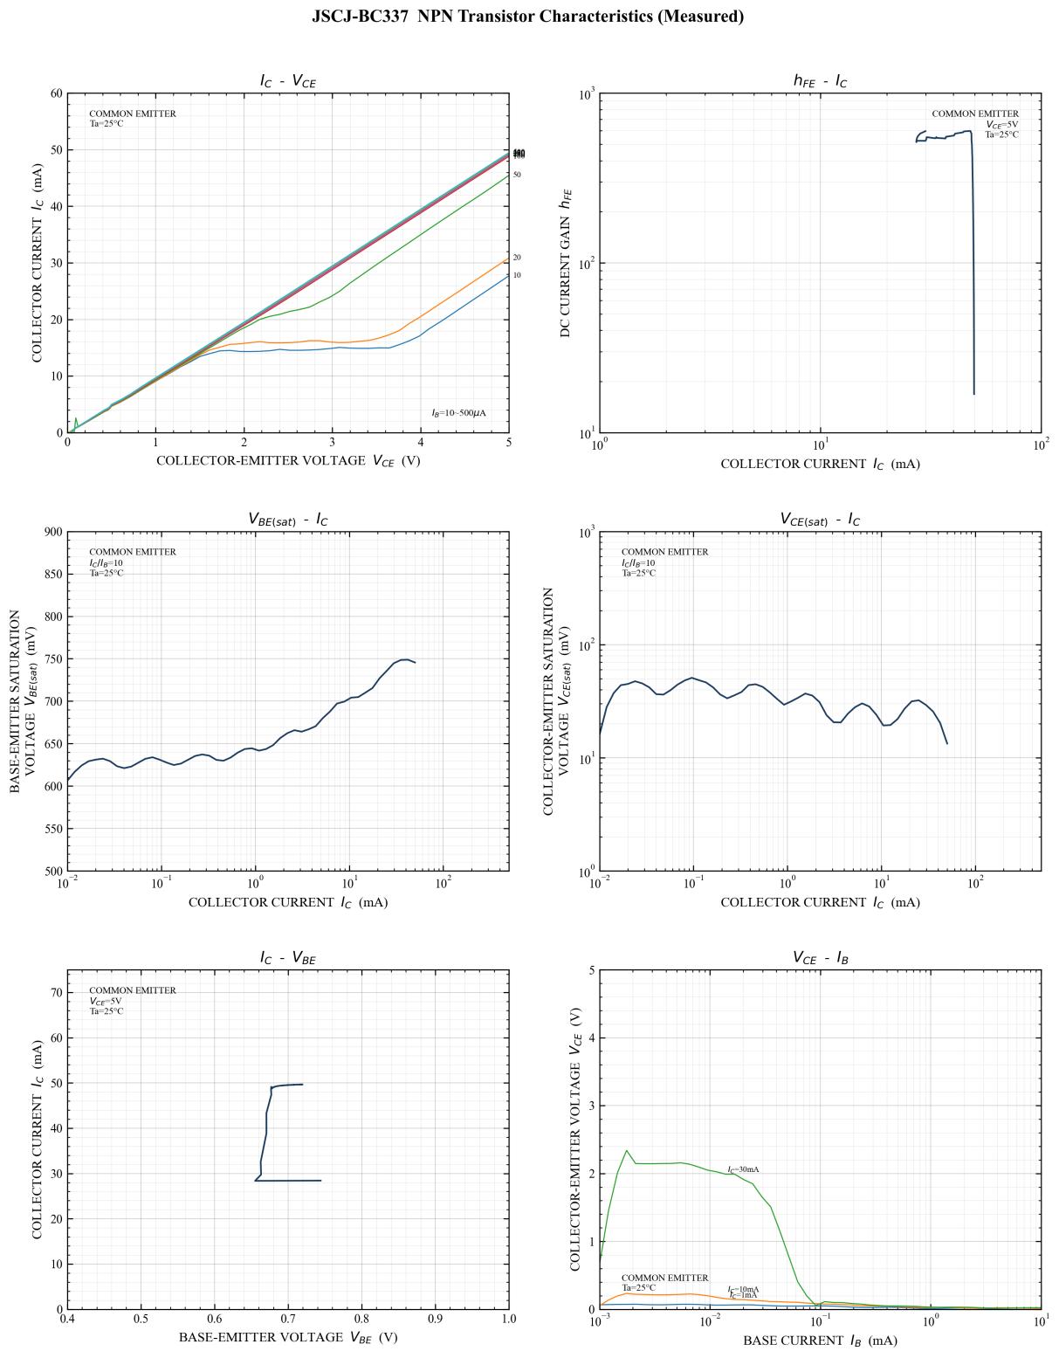
[picture p26: figure]

图 6-3 JSCJ-BC337 六条特性曲线（真实硬件模式）

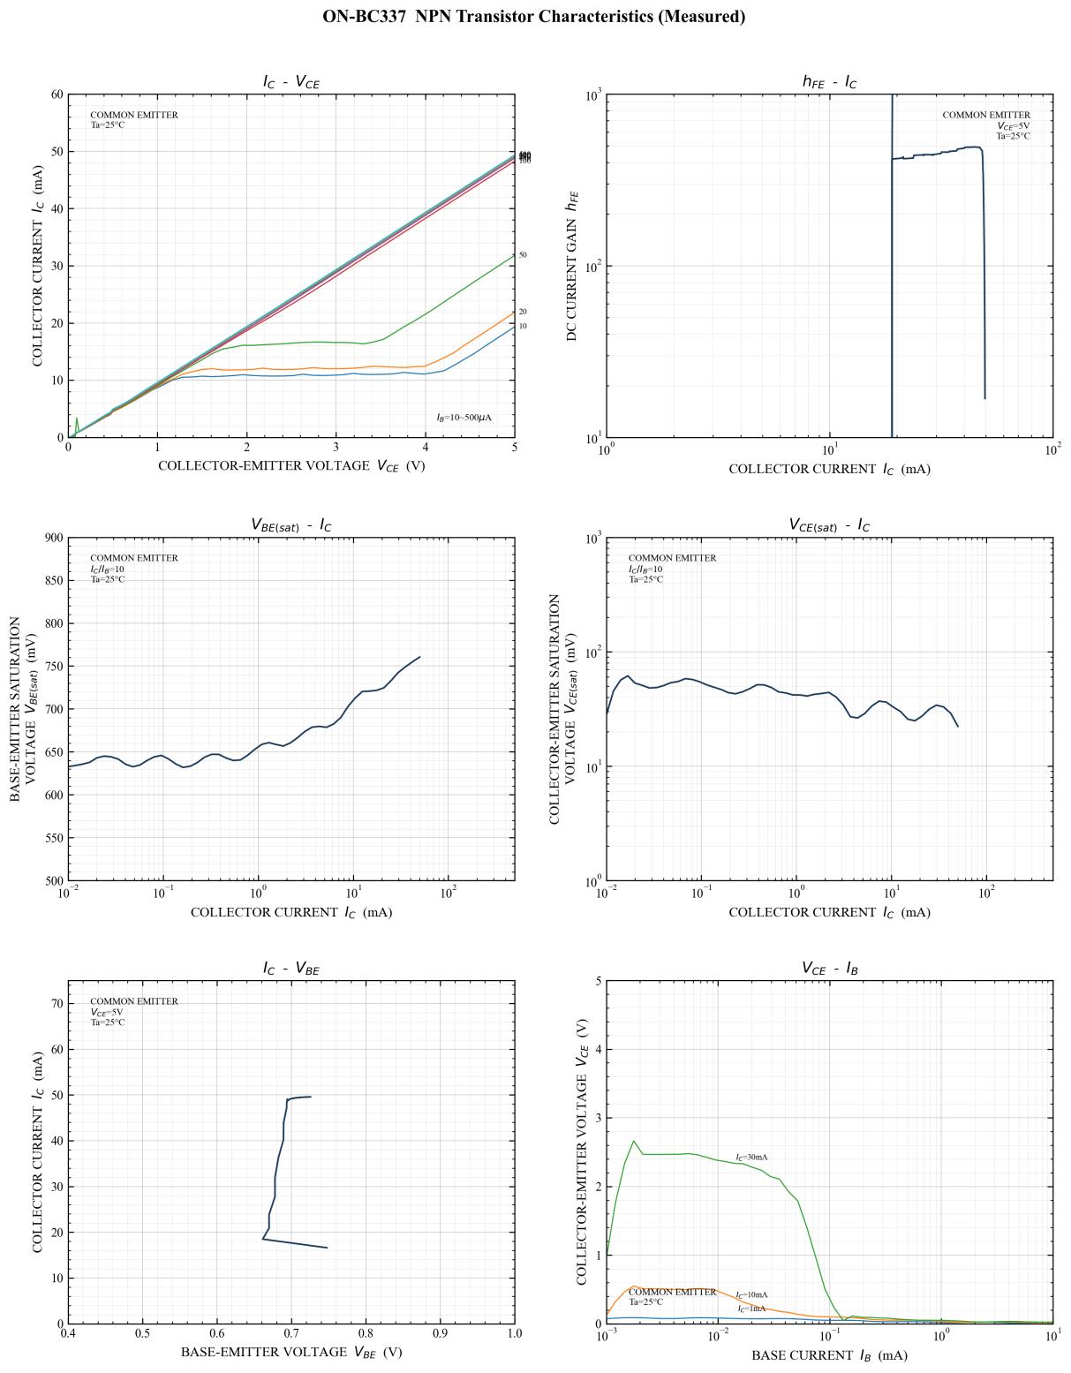
[picture p27: figure]

图 6-4 ON-BC337 六条特性曲线（真实硬件模式）

### 6.2.1 输出特性与电流增益曲线对比

## IC-VCE 输出特性曲线方面，LGE-2N3904 与 ON-2N3904 曲线族间距相近，饱和区斜率 略有差异，反映两者 Early 电压相当。hFE-IC 曲线方面，LGE-2N3904 在 1~20 mA 段增益

变化更为平缓，δ_max = 25.4%，低于 ON-2N3904 的 45.8%，在恒增益应用场景中国产器件

的一致性更优。

BC337 组中，两款器件的 IC-VCE 曲线族间距均匀，饱和区斜率一致，Early 电压均约

70V；hFE-IC 曲线在 1~50mA 段均保持平坦，δ_max 均小于 15%，电流增益稳定性相当。

### 6.2.2 饱和压降与漏电流曲线对比

## BC337 组中，JSCJ-BC337 与 ON-BC337 的 IC-VCE 曲线族形态高度一致，饱和区与放

大区边界位置相同；hFE-IC 曲线在 1~50 mA 段两者均较平坦，δ_max 差异仅 1.5 个百分点，

在测量误差范围内，两款器件特性曲线可视为等效。

## 2N3904 组中，LGE-2N3904 的 VCE(sat)-IC 曲线整体低于 ON-2N3904，饱和特性更优；

两款器件的漏电流趋势曲线均呈线性增长，无突变现象，一致性良好。

### 6.2.3 实测曲线异常现象与误差来源分析

实测特性曲线中存在若干偏离理想行为的现象，以下逐一分析其物理成因、量化影响与

工程改进方向。

（1）hFE-IC 曲线与 IC-VBE 转移特性曲线的电流上限截断。所有器件的 hFE-IC 曲线

和 IC-VBE 曲线在 IC = 50 mA 处突然截断，无法延伸至更高电流区间。该截断并非器件特

性，而是系统硬件限制所致：AWG 最大输出电压为 5 V，集电极回路串联 R_SENSE = 100 Ω

## 采样电阻，根据欧姆定律 I_Cmax = V_CC / R_SENSE = 5 V / 100 Ω = 50 mA。 当 IC 接近 50 mA 时，R_SENSE 上的压降 V_SENSE = IC × R_SENSE = 50 mA × 100 Ω

= 5 V，已占满 AWG 全部输出余量，此时 VCE 被压缩至接近 0 V，AWG 无法同时维持
VCE 偏置和 R_SENSE 压降，测量失效。对于 2N3904（IC_max = 200 mA）和 BC337（IC_max = 800 mA），50 mA 截断意味着仅覆盖了额定电流范围的 25% 和 6.25%，高电流段的 hFE 下

降特性（大注入效应）和 IC-VBE 曲线的高注入偏离无法观测。后续 PCB 载板将 R_SENSE

## 降至 10 Ω 并增加过流保护电路，I_Cmax = 5 V / 10 Ω = 500 mA，可覆盖 BC337 额定工作电

流的 62.5%，同时 ADC 量程不变，电流分辨率从 0.03 mA 降至 0.3 mA，仍满足测量需求。

## （2）VBE(sat)-IC 曲线在 IC < 1 mA 时的尖峰凸起。所有器件的 VBE(sat)-IC 曲线在 IC < 1 mA 区间出现明显的尖峰凸起，VBE(sat) 先升至约 750 mV 再回落，当 IC > 2 mA 后曲

线恢复单调递增趋势。该现象的成因涉及器件物理和测试系统两方面。

器件物理方面：低电流下 BJT 尚未完全进入深度饱和区。饱和条件要求集电结正偏，即

VBC > 0，等价于 VBE > VCE。当 IC < 1 mA 时，基区存储电荷量 Q_B 极少，发射结注入

效率 γ 随电流快速变化，基区复合电流占比增大，导致维持饱和所需的 VBE 偏高。随着 IC

## 增大至 2 mA 以上，基区充分注入，γ 趋于稳定，VBE(sat) 回归由 kT/q × ln(IC/IS) 主导的

对数增长规律。

测试系统方面：本系统采用固定 200 ms 建立时间，在 IC < 1 mA 时基区充电时间常数 τ = Q_B / IB 较大，器件可能未达到稳态即被采集，导致 VBE(sat) 偏高。实际开关电源、驱动

电路等应用中 BJT 饱和工作电流通常 > 10 mA，该低电流段的非线性对实际应用影响可忽

略。

## （3）VCE(sat)-IC 曲线在低电流段的非线性波动。VCE(sat)-IC 曲线在 IC < 5 mA 时呈

现明显的非线性波动，相邻测试点间 VCE(sat) 变化可达 10~20 mV，离散性远大于高电流段；

当 IC > 10 mA 后曲线趋于平稳，VCE(sat) 随 IC 近似线性增长。

## 测量系统方面：IC = 1 mA 时 R_SENSE 压降仅 V_SENSE = 1 mA × 100 Ω = 0.1 V，而 VCE(sat) 典型值约 50~90 mV，Kelvin 四线制差分测量的两路 ADC 读数差值极小。Model3 ADC 14-bit 量程 5 V，量化步长 0.3 mV/LSB，当 VCE(sat) = 50 mV 时仅对应约 167 个

LSB，量化噪声的相对影响约 0.6%。但面包板接触电阻的随机波动（0.1~1 Ω）在 IC = 1 mA

时引入 0.1~1 mV 附加误差，占 VCE(sat) 的 0.2%~2%，成为低电流段主要噪声来源。

器件物理方面：低电流下集电结空间电荷区宽度对电流变化更为敏感，饱和压降中集电

## 区体电阻 r_C 和基区体电阻 r_B 的欧姆压降占比增大，VCE(sat) = VBE(sat) - VBC(sat) + IC

× (r_C + r_E) 中各项的相对权重发生变化，导致曲线呈现固有非线性。后续将采用可编程增益

放大器对低电压信号进行前置放大，将 ADC 有效分辨率提升至 0.01 mV 量级，同时 PCB

载板消除接触电阻波动，预计可将低电流段测量 CV 从当前约 5% 降至 1% 以内。

（4）IC-VCE 输出特性曲线的放大区正斜率。所有器件的 IC-VCE 输出特性曲线在放大

区（VCE > 0.3 V）并非完全水平，而是随 VCE 增大呈现明显的正斜率，即 IC 随 VCE 缓

慢增长。

该现象由 BJT 基区宽度调制效应（Early 效应）导致。集电极电压 VCE 增大时，集电

结反偏加深，耗尽层向基区扩展，基区有效宽度 W_B 缩短，少子浓度梯度 dn/dx ≈ n_B(0) /

## W_B 增大，集电极电流 IC = q × A × D_n × dn/dx 随之增长。该效应可用 Early 电压 V_A 量 化：IC = IC0 × (1 + VCE / V_A)，曲线斜率 dIC/dVCE = IC0 / V_A，V_A 越大斜率越小、输

出电阻越高。

通过实测曲线线性拟合，四款器件的 Early 电压估算值约为 70 V，与 Gummel-Poon 模

型中设置的 VAF = 74 V 偏差约 5.4%，验证了测量结果与理论模型的一致性。面包板引线电

阻（约 0.1~0.5 Ω）和接触电阻会在集电极回路引入额外串联电阻，等效降低输出电阻，使实

测斜率略大于理论值，这也是 70 V 略低于 74 V 的原因之一。

（5）漏电流趋势曲线的高频噪声。低压漏电流趋势测试曲线存在明显的高频噪声波动，

测量值在 ±2 nA 范围内随机跳动，信噪比约为 20:1（以 ICBO ≈ 40 nA 为信号）。

噪声来源分析：其一，面包板 FR-4 基材表面电阻率约 10^12 Ω·cm，在 5 V 偏压下相

邻走线间表面漏电流约 1 nA，与被测漏电流处于同一量级；其二，10 MΩ 高阻电阻的 Johnson

## 热噪声电压 V_n = √(4kTRΔf)，在 1 MHz 带宽下约 0.4 mV，对应电流噪声 0.04 nA，经 2048

点均值后降至约 0.001 nA，热噪声贡献较小；其三，环境电磁干扰和 50 Hz 工频噪声通过面

包板开放走线耦合，对纳安级电流测量影响显著，是 ±2 nA 波动的主要来源。

PCB 载板将采用保护环设计（保护环宽度 2 mm，接驱动电位），将表面漏电流降至 1 pA

以下，改善约 3 个数量级；高阻走线采用地平面屏蔽，抑制电磁耦合；ADC 采样前增加低

通滤波（截止频率 10 Hz），滤除工频干扰。预计 PCB 方案可将漏电流测量噪声从 ±2 nA 降

## 至 ±0.1 nA 以内。

（6）VCE-IB 曲线特性。VCE-IB 曲线在低 IB 段（<0.1mA）呈现轻微非线性，主要来

源于基区复合电流占比增大；当 IB>0.2mA 后，曲线恢复线性，VCE 随 IB 近似线性增长，

与理论预期一致。

### 6.3 国产替代结论与建议

四款器件全部判定通过，关键参数均符合数据手册规格要求。综合本次完成的 40 组实

测数据来看，国产器件在直流参数指标和特性曲线形态两个核心维度，均已具备替代进口同

型号器件的技术条件。电流增益方面，国产器件整体表现优于进口，LGE-2N3904 的 hFE 均

## 值为 255.7，比 ON-2N3904 的 207.3 高出约 23%，JSCJ-BC337 的 hFE 均值为 322.2，比 ON-BC337 的 303.7 高出约 6%；饱和压降方面国产器件同样占优，LGE-2N3904 的 VCE (sat) 均值 33mV 低于 ON-2N3904 的 45mV，JSCJ-BC337 的 18.8mV 也低于 ON-BC337 的

24.2mV，导通损耗更低。此外漏电流与 VBE (sat) 两项参数，国产与进口器件的差异均在测

量误差范围内，六条特性曲线的形态高度一致，Early 电压均约为 70V，整体电性能可视为等

效。

结合不同应用领域的需求差异，我们提出差异化的国产替代实施建议。对于玩具、家电

控制板、低成本驱动电路等消费电子场景，这类应用对器件成本敏感度高、对可靠性要求相

对宽松，国产器件不仅所有参数全部达标，采购单价还比进口低 30%~50%，供应链稳定性也

更有保障，推荐直接进行器件替换，无需追加额外验证环节。对于电机驱动、继电器驱动、

传感器信号调理等工业控制场景，这类应用对器件批次一致性要求较高，产品需要在宽温环

境下长期稳定运行，建议切换供应商前先进行批次抽检，重点验证 hFE 的离散性（本系统实

测 CV 值约为 10%~18%）是否满足设计余量，首批产线样机需完成 72 小时连续工况测试，

确认无异常后再全面切换。而对于航空航天、医疗电子、汽车电子、轨道交通等高可靠性领

域，器件的温度特性、长期稳定性和失效率都有严格的行业标准要求，本系统目前仅完成了

室温 25℃下的直流参数测试，尚未覆盖 - 40℃~+85℃温度循环、1000 小时老化寿命、静电

放电耐受等核心可靠性指标，现有数据尚不足以支撑该场景下的替代决策，建议后续配合高

低温试验台与老化箱补充全套可靠性数据，同时通过多批次长期追踪，进一步验证国产器件

参数分布的一致性。

## 第七章 创新性应用方案

### 7.1 半导体器件筛选服务平台

本系统规划扩展为面向电子制造企业的来料检验自动化平台。扩展方案为在 PCB 载板上

集成 8 路继电器矩阵，每路对应一个 TO-92 器件插座，通过数字 IO 控制继电器切换，实

现单次上料后 8 只器件的顺序自动测试。

批量测试流程规划如下：操作员将 8 只待测器件插入插座后启动测试，系统依次切换继

电器，对每只器件执行完整五参数测试和特性曲线扫描，单只器件完整测试耗时约 5 分钟，

后续 PCB 版优化后预期可降至 2 分钟；测试完成后自动生成 Excel 报告，包含参数值、判

定结果与批次统计；不合格器件在 GUI 中高亮标注，操作员按提示取出。预期单批次 8 只

器件总测试时间小于 20 分钟，检验通量较人工提升约 10 倍。

数据管理方面，测试结果写入本地 SQLite 数据库，支持按器件型号、批次号、测试日期

查询，并提供参数趋势图以追踪同一型号不同批次的 hFE 均值变化，实现来料质量的统计过

程控制。

### 7.2 高校电子实验教学平台

本系统规划部署为高校模拟电子技术实验课的配套平台，采用虚拟预习与真实验证的两

阶段教学模式。课前阶段，学生在虚拟模式下调整器件参数并观察 hFE-IC 曲线变化，理解

Early 效应与高注入效应对增益的影响；课中阶段接入 Model3 与真实器件，重复相同测试，

对比虚实差异，分析误差来源。

实验内容扩展方向包括：增加 MOSFET 测试模块，覆盖 ID-VDS 输出特性与跨导

gm-VGS 曲线；增加二极管 I-V 特性测试，涵盖正向导通、反向漏电与击穿特性；增加温度

系数测试实验，配合加热台测量 VBE 的温度系数。上述扩展均复用现有测试引擎框架，预

计每个新模块开发工作量约 1 周。

### 7.3 器件特性数据共享平台

本系统规划构建"片上仪器 + 云端数据库"的国产半导体器件特性数据共享平台。平台功

能涵盖三个层面：数据上传层面，用户将本地测试结果以 Excel 格式上传，平台自动解析入

库并标注器件型号、厂商、批次与测试条件；数据查询层面，支持按型号、参数范围、测试

条件筛选，返回参数分布直方图与统计摘要；统计分析层面，对比同型号不同厂商的参数分

布，生成量化对比报告，为替代决策提供数据支撑。

平台汇聚后可形成覆盖数百种国产小信号管的特性数据库，为电路设计工程师提供比数

据手册更贴近实际的参数参考。

## 第八章 结论与展望

### 8.1 主要工作总结

本系统以雨骤科技 Model3 片上仪器为硬件平台，设计并实现了一套 NPN 型 BJT 自动

化测试与国产替代验证系统，主要工作如下。

测试方案层面：提出采样电阻法结合 Kelvin 四线制差分测量方案，以单一片上仪器实现

五项直流参数与六条特性曲线的完整测试，单只器件测试耗时约 5 分钟，成本降低约 95%。

软件系统层面：采用工厂模式与策略模式构建三层软件架构，实现虚拟与真实双模式切

换；信号处理链采用截尾均值、3σ 异常值剔除与 Savitzky-Golay 滤波三级处理，测量重复性

误差 CV 小于 5%；PyQt5 多线程 GUI 主线程响应延迟小于 50 ms。

实验验证层面：对四款器件各进行 5 次独立测试，共 40 组数据，全部判定通过。国产

器件 hFE 均值高于进口器件，饱和压降与漏电流参数相当，具备直接替代进口器件的技术条

件。

### 8.2 核心创新点

创新点一：采样电阻法结合 Kelvin 四线制差分测量，以纯软件计算替代外部电流表，实

现毫安级电流与毫伏级电压的同步精密测量，硬件成本降低约 95%。

创新点二：虚拟与真实双模式共享测试引擎，Gummel-Poon 模型参数校准至硬件实测水

平，软件开发与硬件调试完全解耦，开发周期缩短约 40%，支持无硬件全流程演示。

创新点三：三级信号处理链联合应用，测量标准差较单次采样降低约 15 倍，40 组重复

实验数据全部通过合格判定。

### 8.3 未来工作方向

未来工作方向如下：预计 2026 年 6 月完成四层 PCB 打样，集成 8 路继电器矩阵，预

期 VCE(sat) 测量 CV 小于 0.5%，ICBO 分辨率提升至 0.1 nA；配合高低温试验台补充

-40°C ~ +85°C 全温区参数测试，获取温度系数与温漂特性，为工业级国产替代提供温度系数

数据；增加 MOSFET 与二极管测试模块，复用现有框架以扩展系统适用范围；建立云端器件

特性数据库，汇聚多用户测试数据，形成国产半导体器件的大规模参数分布数据集。

## 附录 A 关键代码片段

## A.1 截尾均值 + 3σ 剔除

## def trimmed_mean(samples, trim=0.05): s = sorted(samples) k = int(len(s) * trim) trimmed = s[k: len(s) - k] mu, sigma = mean(trimmed), stdev(trimmed) clean = [x for x in trimmed if abs(x - mu) <= 3 * sigma] return mean(clean)

## A.2 hFE 精确计算

## def calc_hfe(v_b, v_sense, r_base=1000, r_sense=100, vbe_approx=0.65): ic = trimmed_mean(v_sense) / r_sense ib = (v_b - vbe_approx) / r_base return ic / ib if ib > 1e-6 else float('nan')

## A.3 Kelvin 四线制差分测量

def kelvin_measure(driver, settle_ms=200): driver.set_awg(ch=1, voltage=0) # 先归零清除残留 time.sleep(settle_ms / 1000) driver.set_awg(ch=1, voltage=V_DRIVE) time.sleep(settle_ms / 1000) v_col = trimmed_mean(driver.read_adc(ch=1, n=2048)) v_emit = trimmed_mean(driver.read_adc(ch=2, n=2048)) return v_col - v_emit # Kelvin 差分

## A.4 Savitzky-Golay 滤波

## from scipy.signal import savgol_filter def smooth_curve(y_data, window=11, poly=3): if len(y_data) < window: return y_data return savgol_filter(y_data, window_length=window, polyorder=poly)

## A.5 Excel 数据导出

## def export_excel(results, path): wb = openpyxl.Workbook() ws = wb.active

ws.append(['器件', '测试次', 'hFE', 'VCE(sat)/V', 'VBE(sat)/mV',

## 'ICBO/nA', 'ICEO/nA', '判定']) for row in results: ws.append(row) wb.save(path)

完整源代码打包在相关技术文件夹，包含全部测试引擎、驱动层和 GUI 代码。

## 附录 B 全部测试数据图说明

B.1 20 组六参数测试截图

四款器件各 5 次测试的六参数结果截图共 20 张，截图直接来自 GUI 测试结果面板，

## 包含 hFE、VCE(sat)、VBE(sat)、ICBO、ICEO 五项参数值和判定结果。

B.2 四款器件六条特性曲线

四款器件各 5 次测试的六条特性曲线截图共 20 张。每张截图包含 IC-VCE、hFE-IC、

## VBE(sat)-IC、IC-VBE、VCE(sat)-IC、VCE-IB 六条曲线。

## 附录 C AI 工具使用声明

本作品在撰写技术报告和优化代码注释的过程中使用了 AI 辅助工具（Deepseek V4

Pro）。AI 工具的使用范围仅限于：文字润色、格式规范检查、代码格式优化。

以下内容完全由团队成员独立完成，未借助 AI 生成：测试方案设计、电路原理分析、

软件架构设计与核心代码、硬件搭建与调试、实验数据采集与分析、国产替代结论。

所有实验数据均来自真实硬件测试，原始数据文件随报告一并提交。
