TitianMu/BJT-Test-System/hardware/breadboard_circuit.jpg

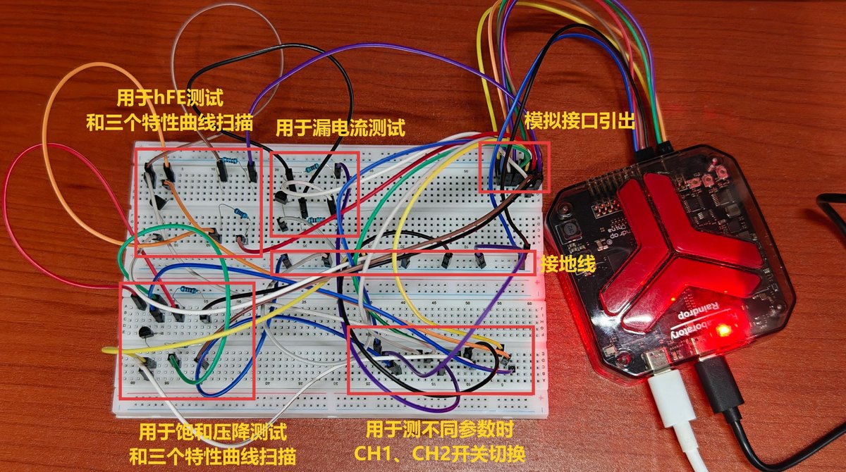
hardware/breadboard_circuit.jpg
