TitianMu/BJT-Test-System/(list of files, drawings)

Other design files:
simulation/反向耐压高压部分.ms14
simulation/放大倍数测试电路.ms14
simulation/漏电流检测.ms14
simulation/频率特性电路.ms14
simulation/频率特性电路（用波特仪测）.ms14
simulation/饱和压降测试电路.ms14
