TitianMu/BJT-Test-System/(commit log)

2026-06-10 @ Initial commit: BJT Automated Testing System
    Core application (15 Python files):
    - PyQt5 GUI with dual-mode (virtual + real hardware)
    - Gummel-Poon SPICE models for 4 BJT devices
    - Factory/Strategy driver architecture
    - Signal processing pipeline (trimmed mean + S-G filter)
    - 6-parameter + 6-curve automated measurement
    Also includes:
    - Technical report (PDF)
    - Multisim simulation circuits (6 files)
    - Hardware photos, architecture diagrams, GUI screenshots
    - MIT License
    @
    [反向耐压高压部分.ms14, 放大倍数测试电路.ms14, 漏电流检测.ms14, 频率特性电路.ms14, 频率特性电路（用波特仪测）.ms14, 饱和压降测试电路.ms14]
2026-06-10 更新：README 与电路资产文件
2026-06-10 更新 README，移除旧架构图
2026-06-10 修复 System Architecture 图片指向 SVG 矢量图
2026-06-10 更新系统架构矢量图
2026-06-10 更新 README 与系统架构图
2026-06-10 README 引用改回 BJT_Test_System_Flowchart.svg
